maromocooo/keyrelay/hardware/case/stl/keyrelay_usba_test_touch.stl

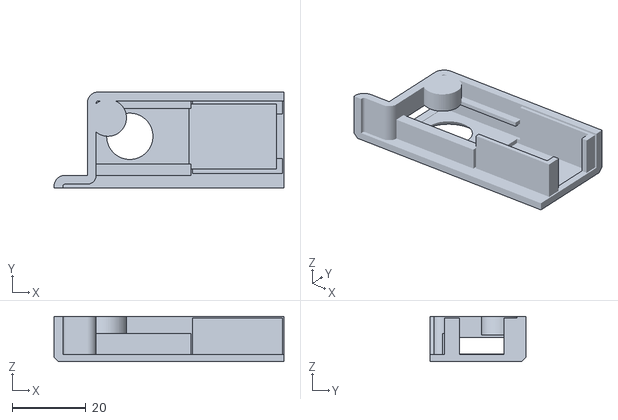
[picture p2: CAD file, 2026-10-23]
hardware/case/stl/keyrelay_usba_test_touch.stl
62.2 x 26.0 x 12.3
