maromocooo/keyrelay/hardware/case/stl/keyrelay_usba_cover.stl

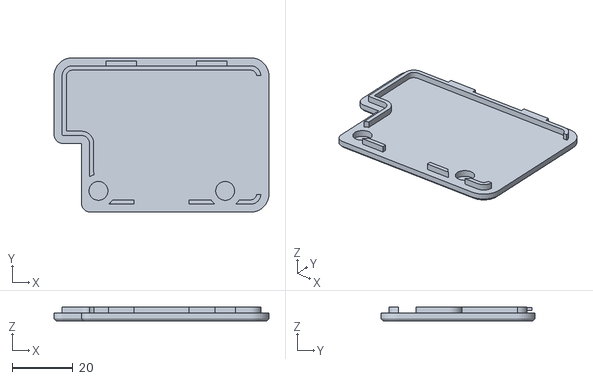
[picture p3: CAD file, 2026-10-23]
hardware/case/stl/keyrelay_usba_cover.stl
70.6 x 50.7 x 4.60
