maromocooo/keyrelay/hardware/case/stl/keyrelay_usba_test_usbc_port.stl

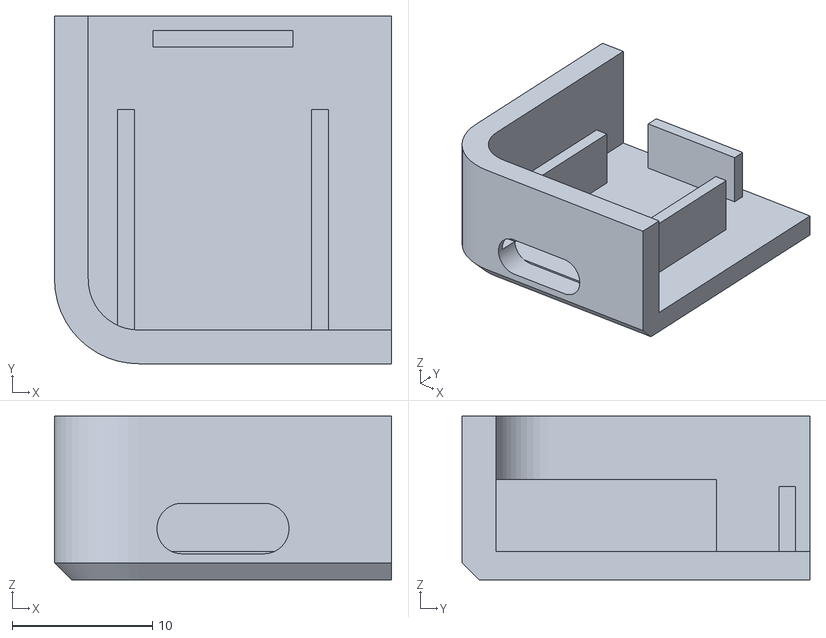
[picture p4: CAD file, 2026-10-23]
hardware/case/stl/keyrelay_usba_test_usbc_port.stl
24.0 x 24.8 x 11.6
