maromocooo/keyrelay/hardware/case/stl/keyrelay_usba_body.stl

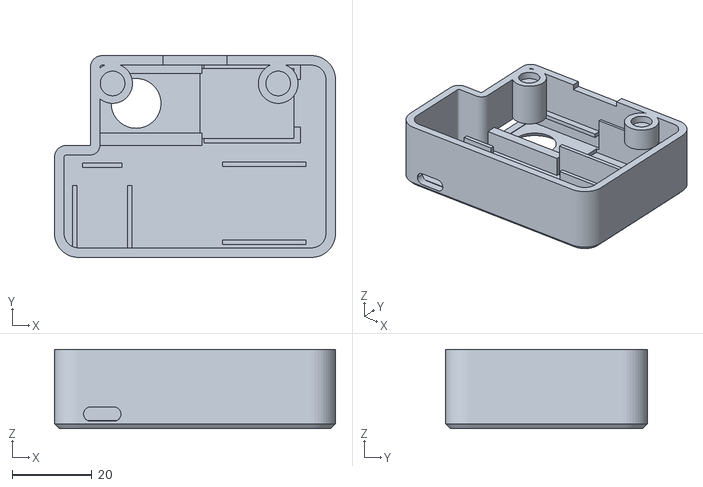
[picture p5: CAD file, 2026-10-23]
hardware/case/stl/keyrelay_usba_body.stl
70.6 x 50.7 x 19.9
