maromocooo/keyrelay/firmware/components/yd_link/yd_link_ble.c

/*
 * yd_link の BLE トランスポート（NimBLE）
 *
 *  机上ユニット = Peripheral（GATTサーバー）
 *      Service  YD_SVC
 *        ├ TO_DESK  : Write Without Response（暗号化必須）  レシーバー → 机上
 *        └ TO_RECV  : Notify                                 机上 → レシーバー
 *  レシーバー = Central（GATTクライアント）
 *      YD_SVC をアドバタイズしている机上ユニットを探して接続 → ペアリング/暗号化
 *      → サービス探索 → TO_RECV の通知を購読 → リンク確立(up)
 *
 *  1パケット = [ch(1) | payload]。BLEはリンク層で順序保証・再送されるのでCRCは不要。
 *
 *  セキュリティ:
 *   - LE Secure Connections + ボンディング（鍵はNVSに保存）
 *   - データの送受信は暗号化済みリンクのみ
 *   - 机上ユニットは「まだ誰ともペアリングしていない」か「起動後 PAIRING_WINDOW_S 秒以内」
 *     だけ新規ペアリングを受け付ける。それ以外は登録済みの相手以外を切断する
 *   - レシーバーは最初にペアリングした机上ユニットのアドレスを覚え、以後それにしか繋がない
 *   - 入出力のない機器同士なので BLE のペアリング自体は Just Works（中間者攻撃に弱い）
 *   - その上に yd_sec（事前共有鍵（鍵ファイル keyrelay-key.bin）と接続ごとの X25519 による相互認証＋
 *     AES-256-GCM）を重ねる。鍵を知らない相手とはペアリングできても1バイトもやり取りしない（yd_sec.h 参照）
 *
 *  状態: s_ready = BLE として送受信できる（暗号化＋購読済み）
 *        s_up    = yd_sec のハンドシェイク完了（ここで初めてアプリに「接続」を知らせる）
 */
#include <string.h>
#include "yd_link_priv.h"
#include "freertos/FreeRTOS.h"
#include "freertos/task.h"
#include "freertos/queue.h"
#include "freertos/semphr.h"
#include <inttypes.h>
#include "esp_log.h"
#include "esp_check.h"
#include "esp_timer.h"
#include "esp_random.h"
#include "esp_partition.h"
#include "yd_sec.h"
#include "yd_bond_policy.h"
#include "nvs_flash.h"
#include "nvs.h"
#include "nimble/nimble_port.h"
#include "nimble/nimble_port_freertos.h"
#include "host/ble_hs.h"
#include "host/util/util.h"
#include "services/gap/ble_svc_gap.h"
#include "services/gatt/ble_svc_gatt.h"
#include "yd_lang.h"

static const char *TAG = "yd_ble";

void ble_store_config_init(void);

#define PAIRING_WINDOW_S   120
#define BLE_PKT_MAX        244          /* 1(ch) + 243 */
#define TXQ_DEPTH          48
#define RXQ_DEPTH          48
#define RXQ_EV_RESERVE     4            /* 受信データで埋めず、接続・切断の通知用に空けておく枠 */

/* 128bit UUID は PSK から作る（yd_sec_gatt_uuid。3つとも別のラベルから）。固定の UUID や名前を出すと、
 * 電波を見るだけで「ここに KeyRelay がある」と分かるため。起動時の ydl_ble_init で埋める */
static ble_uuid128_t UUID_SVC     = { .u = { .type = BLE_UUID_TYPE_128 } };
static ble_uuid128_t UUID_TO_DESK = { .u = { .type = BLE_UUID_TYPE_128 } };
static ble_uuid128_t UUID_TO_RECV = { .u = { .type = BLE_UUID_TYPE_128 } };
/* 古い版（固定の UUID を出していたころ）の机上ユニットのサービス。見つけたらログで知らせるだけで、つながない */
static const ble_uuid128_t UUID_LEGACY_SVC = BLE_UUID128_INIT(0x01, 0xee, 0xff, 0xc0, 0xd0, 0x59, 0x2d, 0x9b,
                                                              0x6e, 0x4f, 0x4a, 0x5c, 0x00, 0x00, 0x1e, 0x7d);

#define HS_TIMEOUT_MS      5000          /* 暗号化・購読の後、この時間内に相互認証が終わらなければ切断 */
#define CONN_AUTH_TIMEOUT_MS 15000       /* 接続してから、この時間内に相互認証まで終わらなければ切断 */
#define KEY_PARTITION      "ydkey"       /* 鍵を書き込むパーティション（partitions.csv） */

typedef enum {
    PK_DATA = 0,        /* rx: 相手から届いたパケット / tx: アプリのデータ（暗号化して送る） */
    PK_RAW,             /* tx: ハンドシェイク（そのまま送る） */
    PK_EV_READY,        /* rx: BLE として送受信できるようになった（ハンドシェイク開始） */
    PK_EV_DOWN,         /* rx: 切れた */
} pk_kind_t;

typedef struct {
    uint8_t kind;
    uint16_t len;
    uint16_t conn;      /* tx: 送り先の接続（キューに入れた時点のもの） */
    uint32_t gen;       /* キューに入れた時点の接続の世代。違えば古い接続のものなので捨てる */
    uint8_t buf[BLE_PKT_MAX];
} pkt_t;

static yd_link_config_t s_cfg;
static bool s_is_central;
static uint8_t s_own_addr_type;
static QueueHandle_t s_txq, s_rxq;

/* いまの接続と、その接続の状態。下の5つは s_link_mutex を持って変える。
 *  - s_conn と s_gen（接続の世代）を変えるのは NimBLE のホストタスクだけ（接続・切断のとき。link_begin / link_end）。
 *    世代は接続・切断のたびに増える
 *  - 送受信キューのパケット、ハンドシェイクの状態、タイマーは、どの世代のものかを持っている。切断を決める
 *    （close_conn）・s_up を上げる（link_authed）・送る（tx_task）ときに、ロックの中でそれが今の世代かを確かめる。
 *    切断と再接続が処理の途中に起きても、古い接続の処理が新しい接続を切ったり、新しい接続に送ったり、
 *    新しい接続を認証済みにしたりしない（接続ハンドルの番号は使い回されるので、ハンドルだけでは見分けられない）
 *  - ロックを持ったまま呼ぶ NimBLE の関数（ble_gap_terminate と送信）は、ホストタスクを待たない
 *    （HCI コマンドの応答はコントローラー側の文脈で処理される）。ただし通知の送信（ble_gatts_notify_custom）は、
 *    送ったタスクの中で GAP の BLE_GAP_EVENT_NOTIFY_TX を呼ぶ。GAP のイベント処理で、そのイベントのときに
 *    s_link_mutex を取ってはいけない
 *  - s_up を変えたら notify_state() でアプリに知らせる（ロックを離してから） */
static volatile uint16_t s_conn = BLE_HS_CONN_HANDLE_NONE;
static volatile uint32_t s_gen;
static volatile bool s_up;                     /* yd_sec の相互認証まで完了（アプリにとっての「接続」） */
static volatile bool s_closing;                /* 切ると決めた。切断が終わるまでデータもハンドシェイクも進めない */
static volatile bool s_conn_authed;            /* この接続で相互認証が通った */
static volatile bool s_key_mismatch;           /* 相手の PSK が違う（AUTH が合わない）ので、こちらから切った */
static SemaphoreHandle_t s_link_mutex;
static SemaphoreHandle_t s_state_mutex;        /* state_cb を1つずつ呼ぶ */
static bool s_reported_up;                     /* state_cb で最後に知らせた値（s_state_mutex で守る） */

static volatile bool s_encrypted;
static volatile bool s_ready;        /* BLEとして送受信可（暗号化＋購読済み）。ホストタスクが変える */
static volatile bool s_subscribed;   /* peripheral: 相手が通知を購読中 */

/* peripheral */
static uint16_t s_to_desk_val, s_to_recv_val;      /* GATTサーバーのハンドル */
/* central */
static uint16_t s_svc_start, s_svc_end;
static uint16_t s_peer_to_desk, s_peer_to_recv;
static bool s_have_target;

/* いま接続している相手（暗号化できた時点で記録）。PSK の相互認証に失敗した相手と、
 * この接続で新しくペアリングしたのに認証まで進まなかった相手は、切断時に BLE のボンド情報も消す
 * （yd_bond_policy.h）。鍵を持たない偽の機器に「登録済みの相手」や新規ペアリングの枠を
 * 取られたままにしないため */
static ble_addr_t s_peer_addr;                 /* s_peer_addr_valid とともに、ホストタスクが s_link_mutex を持って変える */
static volatile bool s_peer_addr_valid;
static volatile bool s_conn_was_bonded;        /* 接続した時点で、この相手のボンドがあった（ホストタスク） */
static volatile uint32_t s_ev_drops;           /* 受信キューに状態の通知を入れられなかった回数 */
static uint32_t s_bond_delete_fail;            /* 消すべきボンドを消せなかった回数 */
static ble_addr_t s_target;

/* 受付時間中の再ペアリングで消した、古いボンドの退避（机上ユニット。yd_bond_policy.h）。ホストタスクだけが触る
 * （ydl_ble_forget_peers は active を下ろすだけ）。RAM だけに置き、再起動したら消える */
static struct {
    volatile bool active;
    uint32_t gen;                              /* 退避した接続の世代 */
    ble_addr_t addr;
    struct ble_store_value_sec our, peer;
    struct ble_store_value_cccd cccd;          /* レシーバーの通知の購読 */
    bool have_cccd;
} s_stash;

/* ======================================================================
 *  接続パラメータの省電力切り替え（Peripheral = 机上ユニットのみ）
 *
 *  通信中 : 間隔15〜30ms / レイテンシ0         → 低遅延
 *  無通信 : 間隔30ms / レイテンシ12            → 実質 (1+12)*30 = 390ms ごとにだけ起きる
 *           スーパービジョンタイムアウト 6s（≥ (1+12)*30ms*2 = 780ms かつ ≥ 4s）
 *  送受信があれば即座に「通信中」を要求し、CP_IDLE_AFTER_MS 無通信で「無通信」へ戻す。
 *  Central（レシーバー）は NimBLE 既定どおり相手の要求をそのまま受け入れる。
 * ====================================================================== */
#define CP_ACTIVE_ITVL_MIN_MS   15
#define CP_ACTIVE_ITVL_MAX_MS   30
#define CP_ACTIVE_LATENCY       0
#define CP_ACTIVE_TIMEOUT_MS    4000
#define CP_IDLE_ITVL_MS         30
#define CP_IDLE_LATENCY         12
#define CP_IDLE_TIMEOUT_MS      6000
#define CP_IDLE_AFTER_MS        3000     /* この時間無通信なら省電力パラメータへ */
#define CP_RETRY_MS             10000    /* 更新が失敗/拒否されたら次に試すまでの間隔 */
#define CP_TICK_MS              1000     /* 判定周期（tx_task のキュー待ちタイムアウト） */

static portMUX_TYPE s_cp_mux = portMUX_INITIALIZER_UNLOCKED;
static bool s_cp_enabled;                /* ble_conn_power_save && Peripheral */
static volatile bool s_cp_idle;          /* いま適用されているのが省電力パラメータか */
static volatile bool s_cp_want_idle;     /* 目標 */
static volatile bool s_cp_pending;       /* 更新手続き中 */
static int64_t s_cp_last_traffic_us;
static int64_t s_cp_retry_at_us;

static void cp_request(bool idle)
{
    struct ble_gap_upd_params p = { 0 };
    if (idle) {
        p.itvl_min = BLE_GAP_CONN_ITVL_MS(CP_IDLE_ITVL_MS);
        p.itvl_max = BLE_GAP_CONN_ITVL_MS(CP_IDLE_ITVL_MS);
        p.latency = CP_IDLE_LATENCY;
        p.supervision_timeout = BLE_GAP_SUPERVISION_TIMEOUT_MS(CP_IDLE_TIMEOUT_MS);
    } else {
        p.itvl_min = BLE_GAP_CONN_ITVL_MS(CP_ACTIVE_ITVL_MIN_MS);
        p.itvl_max = BLE_GAP_CONN_ITVL_MS(CP_ACTIVE_ITVL_MAX_MS);
        p.latency = CP_ACTIVE_LATENCY;
        p.supervision_timeout = BLE_GAP_SUPERVISION_TIMEOUT_MS(CP_ACTIVE_TIMEOUT_MS);
    }
    uint16_t conn = s_conn;
    int rc = (conn == BLE_HS_CONN_HANDLE_NONE) ? BLE_HS_ENOTCONN : ble_gap_update_params(conn, &p);
    if (rc == 0) {
        ESP_LOGI(TAG, YD_L("Requesting connection parameters: %s", "接続パラメータ変更を要求: %s"), idle ? YD_L("power save (30ms / latency 12 / 6s)", "省電力（30ms / latency 12 / 6s）") : YD_L("low latency (15-30ms / latency 0 / 4s)", "低遅延（15-30ms / latency 0 / 4s）"));
        return;
    }
    portENTER_CRITICAL(&s_cp_mux);
    s_cp_pending = false;
    /* 低遅延への切り替えはすぐ再試行、省電力側は少し待つ */
    s_cp_retry_at_us = esp_timer_get_time() + (idle ? (int64_t)CP_RETRY_MS * 1000 : 200 * 1000);
    portEXIT_CRITICAL(&s_cp_mux);
    ESP_LOGW(TAG, YD_L("Connection parameter request failed rc=%d (will retry)", "接続パラメータ変更の要求に失敗 rc=%d（後で再試行）"), rc);
}

/* 目標と現状が違えば更新を要求する（どのタスクから呼んでもよい） */
static void cp_eval(void)
{
    if (!s_cp_enabled || !s_up) {
        return;
    }
    bool req = false, want = false;
    int64_t now = esp_timer_get_time();
    portENTER_CRITICAL(&s_cp_mux);
    if (!s_cp_want_idle && (now - s_cp_last_traffic_us) >= (int64_t)CP_IDLE_AFTER_MS * 1000) {
        s_cp_want_idle = true;
    }
    want = s_cp_want_idle;
    if (want != s_cp_idle && !s_cp_pending && (!want || now >= s_cp_retry_at_us)) {
        s_cp_pending = true;
        req = true;
    }
    portEXIT_CRITICAL(&s_cp_mux);
    if (req) {
        cp_request(want);
    }
}

/* 送受信のたびに呼ぶ。省電力側なら低遅延側へ戻す */
static void cp_on_traffic(void)
{
    if (!s_cp_enabled) {
        return;
    }
    portENTER_CRITICAL(&s_cp_mux);
    s_cp_last_traffic_us = esp_timer_get_time();
    s_cp_want_idle = false;
    bool need = s_cp_idle && !s_cp_pending;
    portEXIT_CRITICAL(&s_cp_mux);
    if (need) {
        cp_eval();
    }
}

static void cp_reset(bool idle_now)
{
    portENTER_CRITICAL(&s_cp_mux);
    s_cp_idle = idle_now;
    s_cp_want_idle = false;
    s_cp_pending = false;
    s_cp_last_traffic_us = esp_timer_get_time();
    s_cp_retry_at_us = 0;
    portEXIT_CRITICAL(&s_cp_mux);
}

static void log_conn_params(const char *label, uint16_t conn)
{
    struct ble_gap_conn_desc d;
    if (ble_gap_conn_find(conn, &d) != 0) {
        return;
    }
    unsigned itvl_x100 = (unsigned)d.conn_itvl * 125;   /* 1.25ms単位 → 0.01ms単位 */
    ESP_LOGI(TAG, YD_L("%s interval=%u.%02ums latency=%u timeout=%ums (effective wake-up interval ~%ums)", "%s interval=%u.%02ums latency=%u timeout=%ums（実質の起床間隔 約%ums）"),
             label, itvl_x100 / 100, itvl_x100 % 100, d.conn_latency, (unsigned)d.supervision_timeout * 10,
             (unsigned)(itvl_x100 * (1u + d.conn_latency)) / 100);
}

void ydl_ble_get_conn_info(yd_link_conn_info_t *out)
{
    struct ble_gap_conn_desc d;
    uint16_t conn = s_conn;
    out->connected = s_up;
    out->power_save = s_cp_idle;
    out->update_pending = s_cp_pending;
    if (conn != BLE_HS_CONN_HANDLE_NONE && ble_gap_conn_find(conn, &d) == 0) {
        out->itvl = d.conn_itvl;
        out->latency = d.conn_latency;
        out->timeout = d.supervision_timeout;
    }
}

/* s_up が変わっていたらアプリに知らせる。s_up を変えたタスクが、s_link_mutex を離してから呼ぶ
 * （state_cb の中から送信できるように）。複数のタスクが続けて変えても、最後に知らせる値は今の s_up になる
 * （途中の変化は飛ばすことがある） */
static void notify_state(void)
{
    xSemaphoreTake(s_state_mutex, portMAX_DELAY);
    bool up = s_up;
    if (up != s_reported_up) {
        s_reported_up = up;
        ESP_LOGI(TAG, "%s", up ? YD_L("▶ BLE link up (encrypted, mutually authenticated with the key)", "▶ BLEリンク確立（暗号化＋鍵による相互認証済み）") : YD_L("■ BLE link down", "■ BLEリンク切断"));
        if (up && s_cp_enabled) {
            /* 確立直後はレシーバーが指定した低遅延パラメータ。CP_IDLE_AFTER_MS 後に省電力へ */
            struct ble_gap_conn_desc d;
            uint16_t c = s_conn;
            cp_reset(c != BLE_HS_CONN_HANDLE_NONE && ble_gap_conn_find(c, &d) == 0 && d.conn_latency > 0);
        }
        if (s_cfg.state_cb) {
            s_cfg.state_cb(up, s_cfg.state_cb_arg);
        }
    }
    xSemaphoreGive(s_state_mutex);
}

static void print_addr(const char *label, const ble_addr_t *a)
{
    const uint8_t *v = a->val;
    ESP_LOGI(TAG, "%s %02x:%02x:%02x:%02x:%02x:%02x", label, v[5], v[4], v[3], v[2], v[1], v[0]);
}

static int bond_count(void)
{
    int n = 0;
    ble_store_util_count(BLE_STORE_OBJ_TYPE_OUR_SEC, &n);
    return n;
}

static bool peer_is_bonded(const ble_addr_t *addr)
{
    struct ble_store_key_sec key = { .peer_addr = *addr };
    struct ble_store_value_sec val;
    return ble_store_read_peer_sec(&key, &val) == 0;
}

static bool pairing_window_open(void)
{
    return bond_count() == 0 || esp_timer_get_time() < (int64_t)PAIRING_WINDOW_S * 1000000;
}

/* ---- NVS: レシーバーが覚える相手アドレス ---- */
static void target_load(void)
{
    nvs_handle_t h;
    if (nvs_open("yd_link", NVS_READONLY, &h) != ESP_OK) {
        return;
    }
    size_t sz = sizeof(s_target);
    s_have_target = (nvs_get_blob(h, "target", &s_target, &sz) == ESP_OK && sz == sizeof(s_target));
    nvs_close(h);
}

/* 登録済みの机上ユニットか（レシーバー） */
static bool is_target(const ble_addr_t *a)
{
    return s_have_target && ble_addr_cmp(a, &s_target) == 0;
}

static void target_save(const ble_addr_t *a)
{
    nvs_handle_t h;
    if (nvs_open("yd_link", NVS_READWRITE, &h) != ESP_OK) {
        return;
    }
    nvs_set_blob(h, "target", a, sizeof(*a));
    nvs_commit(h);
    nvs_close(h);
    s_target = *a;
    s_have_target = true;
}

/* ======================================================================
 *  受信・送信タスク（NimBLEホストタスクを塞がないため）
 * ====================================================================== */
/* ======================================================================
 *  yd_sec: 事前共有鍵による相互認証と暗号化（ハンドシェイクは rx_task だけが触る）
 * ====================================================================== */
static uint8_t s_psk[YD_SEC_KEY_LEN];
static bool s_have_psk;
static SemaphoreHandle_t s_sec_mutex;      /* tx_task（暗号化）と rx_task（鍵の更新）の排他 */
static yd_sec_keys_t s_keys;
static uint8_t s_my_nonce[YD_SEC_NONCE_LEN], s_peer_nonce[YD_SEC_NONCE_LEN];
static uint8_t s_my_esk[YD_SEC_EPK_LEN];                      /* この接続だけの X25519 秘密鍵（RAM のみ） */
static uint8_t s_my_epk[YD_SEC_EPK_LEN], s_peer_epk[YD_SEC_EPK_LEN];
static int64_t s_x25519_us;                                    /* X25519 の計算にかかった時間（ログ用） */
static uint8_t s_peer_mac[YD_SEC_MAC_LEN];
static bool s_hs_hello_sent, s_hs_peer_hello, s_hs_keys, s_hs_auth_sent, s_hs_peer_auth;
static bool s_keys_valid;              /* s_keys がこの接続の鍵（s_sec_mutex で守る） */
static uint32_t s_tx_ctr, s_rx_ctr;
static uint32_t s_rx_overflows_seen;   /* 鍵を作ったときの g_ydl_stats.rx_overflows（抜けの原因の見分け用） */
static esp_timer_handle_t s_hs_timer;
static esp_timer_handle_t s_conn_timer;
/* タイマーをどの世代の接続のために、いつまでの期限で動かしたか（s_link_mutex で守る）。止めたはずの前の分が
 * 遅れて呼ばれても、期限前なら何もしない */
static uint32_t s_hs_timer_gen, s_conn_timer_gen;
static int64_t s_hs_timer_due_us, s_conn_timer_due_us;
static uint32_t s_hs_gen;                    /* ハンドシェイクの状態（上の s_hs_* と鍵）がどの世代のものか（rx_task だけが触る） */
static uint16_t s_hs_conn;                   /* その接続のハンドル */
static TaskHandle_t s_rx_task;
static uint32_t s_sec_fail;

/* 接続した（ホストタスク）。新しい世代を始め、接続ごとの状態を初期値に戻す */
static void link_begin(uint16_t conn)
{
    xSemaphoreTake(s_link_mutex, portMAX_DELAY);
    s_conn = conn;
    s_gen++;
    s_up = false;
    s_closing = false;
    s_conn_authed = false;
    s_key_mismatch = false;
    s_peer_addr_valid = false;
    xSemaphoreGive(s_link_mutex);
    notify_state();
}

/* 暗号化できた相手のアドレスを覚える（ホストタスク） */
static void link_set_peer(const ble_addr_t *a)
{
    xSemaphoreTake(s_link_mutex, portMAX_DELAY);
    s_peer_addr = *a;
    s_peer_addr_valid = true;
    xSemaphoreGive(s_link_mutex);
}

/* 切れた（ホストタスク）。切れた接続が認証済みだったか・相手の PSK が違うので切ったかと、その接続の世代を返す。
 * 世代が変わるので、これより後に古い接続の処理が切断を決めても、もう何も変わらない */
static uint32_t link_end(bool *authed, bool *key_mismatch)
{
    xSemaphoreTake(s_link_mutex, portMAX_DELAY);
    uint32_t gen = s_gen;
    *authed = s_conn_authed;
    *key_mismatch = s_key_mismatch;
    s_conn = BLE_HS_CONN_HANDLE_NONE;
    s_gen++;
    s_up = false;
    s_closing = false;
    s_conn_authed = false;
    s_key_mismatch = false;
    xSemaphoreGive(s_link_mutex);
    notify_state();
    return gen;
}

/* いまの接続と世代を、組み合わせが崩れないように読む。その時点で相互認証が済んでいれば（s_up）true */
static bool link_snapshot(uint16_t *conn, uint32_t *gen)
{
    xSemaphoreTake(s_link_mutex, portMAX_DELAY);
    *conn = s_conn;
    *gen = s_gen;
    bool up = s_up;
    xSemaphoreGive(s_link_mutex);
    return up;
}

/* BLE として送受信できなくなった（ホストタスク。購読の解除など、接続は残ることがある） */
static void link_clear_up(void)
{
    xSemaphoreTake(s_link_mutex, portMAX_DELAY);
    s_up = false;
    xSemaphoreGive(s_link_mutex);
    notify_state();
}

/* 相互認証が通った（rx_task）。gen がまだ今の接続で、切ると決めていなければ s_up を上げて true。
 * 相互認証までの時間切れタイマーもここで止める（ロックの中なので、次の接続のタイマーは止めない）。
 * *peer_valid と *peer に、その接続の相手のアドレス（暗号化できていれば）を返す */
static bool link_authed(uint32_t gen, ble_addr_t *peer, bool *peer_valid)
{
    bool ok = false;
    xSemaphoreTake(s_link_mutex, portMAX_DELAY);
    if (gen == s_gen && s_conn != BLE_HS_CONN_HANDLE_NONE && s_ready && !s_closing) {
        s_conn_authed = true;
        s_up = true;
        esp_timer_stop(s_hs_timer);
        esp_timer_stop(s_conn_timer);
        ok = true;
    }
    *peer_valid = ok && s_peer_addr_valid;
    *peer = s_peer_addr;
    xSemaphoreGive(s_link_mutex);
    return ok;
}

/* 鍵を消した（rx_task。EV_DOWN）。同じ接続のまま購読をやり直したとき、その間に終わったハンドシェイクで
 * 上げた s_up を残さない。残ると、鍵のないまま「接続中」のままになり、次のハンドシェイクも始まらない */
static void link_keys_gone(uint32_t gen)
{
    bool changed = false;
    xSemaphoreTake(s_link_mutex, portMAX_DELAY);
    if (gen == s_gen && s_up) {
        s_up = false;
        changed = true;
    }
    xSemaphoreGive(s_link_mutex);
    if (changed) {
        notify_state();
    }
}

#define CLOSE_HS_FAIL        0x01   /* 鍵の相互認証の前の失敗として切る（ログをエラーにする） */
#define CLOSE_UNLESS_UP      0x02   /* いま相互認証が済んでいれば（s_up）切らない */
#define CLOSE_UNLESS_AUTHED  0x04   /* この接続で一度でも相互認証が通っていれば切らない */
#define CLOSE_KEY_MISMATCH   0x08   /* 相手の PSK が違う。前からのボンドも消す（yd_bond_policy.h） */

/* gen の接続を切ると決めて、切断を要求する。切ったら true。gen がもう今の接続でない（切れた後の、古い接続の
 * 処理から呼ばれた）とき、すでに切ると決めているとき、flags の条件に当たるときは何もしない。
 * why を渡せば、切ったときにログに出す */
static bool close_conn(uint32_t gen, unsigned flags, const char *why)
{
    bool closed = false;
    xSemaphoreTake(s_link_mutex, portMAX_DELAY);
    if (gen == s_gen && s_conn != BLE_HS_CONN_HANDLE_NONE && !s_closing &&
        !((flags & CLOSE_UNLESS_UP) && s_up) && !((flags & CLOSE_UNLESS_AUTHED) && s_conn_authed)) {
        if ((flags & CLOSE_KEY_MISMATCH) && !s_up) {
            /* 相手の PSK が違う。前からのボンドでも消す。それ以外の認証前の失敗（時間切れ・形のおかしい HELLO/AUTH
             * など）では、この接続で作ったボンドだけを消す（conn_end）。前からのボンドを使って暗号化できた相手は
             * 本物の相手で、こちらだけが忘れると、相手は暗号化に失敗し続けてつながらなくなるため */
            s_key_mismatch = true;
        }
        s_closing = true;
        s_up = false;      /* 切断が終わるのを待たずに送受信を止める（後続の通し番号を相手に送らない） */
        ble_gap_terminate(s_conn, (flags & CLOSE_HS_FAIL) ? BLE_ERR_AUTH_FAIL : BLE_ERR_REM_USER_CONN_TERM);
        closed = true;
    }
    xSemaphoreGive(s_link_mutex);
    if (closed) {
        if (why && (flags & CLOSE_HS_FAIL)) {
            ESP_LOGE(TAG, YD_L("%s → disconnecting", "%s → 切断します"), why);
        } else if (why) {
            ESP_LOGW(TAG, YD_L("%s → disconnecting", "%s → 切断します"), why);
        }
        notify_state();
    }
    return closed;
}

/* 接続・切断の通知。受信データと同じキューに入れて順番を保つ（切断より前のデータは、
 * 切断の処理より先に読まれる）。push_rx は最後の RXQ_EV_RESERVE 枠を使わないので、相手が
 * データを送りつけてキューを埋めても、通知は入る。どちらも NimBLE のホストタスクからしか
 * 呼ばれないので、空きの確認と投入の間に割り込まれることはない */
static void post_event(pk_kind_t kind)
{
    pkt_t p = { .kind = kind, .len = 0, .conn = s_conn, .gen = s_gen };   /* ホストタスク（書き手）から呼ばれる */
    if (xQueueSend(s_rxq, &p, pdMS_TO_TICKS(100)) != pdTRUE) {
        s_ev_drops++;
        ESP_LOGE(TAG, YD_L("Could not queue a link state event (#%", "接続状態の通知をキューに入れられませんでした（%") PRIu32 YD_L(") → disconnecting", "回目）→ 切断します"), s_ev_drops);
        uint16_t c = s_conn;
        if (c != BLE_HS_CONN_HANDLE_NONE) {
            ble_gap_terminate(c, BLE_ERR_REM_USER_CONN_TERM);
        }
    }
}

/* BLE層の「送受信できる / できない」。アプリへの通知はハンドシェイク完了後 */
static void transport_ready(bool ready)
{
    if (ready && s_ready) {
        return;
    }
    /* 切断は毎回通知する（準備完了前に届いたHELLOなどの状態も確実に消すため） */
    s_ready = ready;
    if (!ready) {
        link_clear_up();            /* 先に送信を止める */
        if (s_hs_timer) {
            esp_timer_stop(s_hs_timer);
        }
    }
    post_event(ready ? PK_EV_READY : PK_EV_DOWN);
}

/* rx_task の中から、いま処理しているハンドシェイクの接続を切る（古い接続の処理なら何もしない）。
 * hs_fail: 失敗として切る（この接続で作ったボンドは消え、前からのボンドは残る）
 * hs_mismatch: 相手の PSK が違うとして切る（前からのボンドも消す）
 * hs_drop: 失敗の印を付けずに切る（版の違い・取りこぼしなど） */
static void hs_fail(const char *why)
{
    close_conn(s_hs_gen, CLOSE_HS_FAIL, why);
}

static void hs_mismatch(const char *why)
{
    close_conn(s_hs_gen, CLOSE_HS_FAIL | CLOSE_KEY_MISMATCH, why);
}

static void hs_drop(const char *why)
{
    close_conn(s_hs_gen, 0, why);
}

static int esp_rng(void *ctx, unsigned char *buf, size_t len)
{
    (void)ctx;
    esp_fill_random(buf, len);
    return 0;
}

/* タイマーを動かす。gen の接続のため、timeout_ms 後まで */
static void timer_arm(esp_timer_handle_t t, uint32_t *gen_slot, int64_t *due_slot, uint32_t gen, uint32_t timeout_ms)
{
    esp_timer_stop(t);
    xSemaphoreTake(s_link_mutex, portMAX_DELAY);
    *gen_slot = gen;
    *due_slot = esp_timer_get_time() + (int64_t)timeout_ms * 1000;
    xSemaphoreGive(s_link_mutex);
    esp_timer_start_once(t, (uint64_t)timeout_ms * 1000);
}

/* タイマーの呼び出しが、いま動かしている分の期限によるものなら true と、その世代 */
static bool timer_due(const uint32_t *gen_slot, const int64_t *due_slot, uint32_t *gen)
{
    xSemaphoreTake(s_link_mutex, portMAX_DELAY);
    *gen = *gen_slot;
    bool due = esp_timer_get_time() >= *due_slot - 2000;    /* 2ms の余裕（前に動かした分は何秒も前の期限） */
    xSemaphoreGive(s_link_mutex);
    return due;
}

static void hs_timeout_cb(void *arg)
{
    uint32_t gen;
    if (timer_due(&s_hs_timer_gen, &s_hs_timer_due_us, &gen) && s_ready) {
        close_conn(gen, CLOSE_HS_FAIL | CLOSE_UNLESS_UP,
                   YD_L("Key-based mutual authentication timed out (peer firmware may be old, or it has no key)", "鍵による相互認証が時間内に終わりませんでした（相手のファームが古いか、鍵がない可能性）"));
    }
}

/* 接続してから相互認証が終わるまでの上限。s_hs_timer は暗号化と購読が済んでから動くので、
 * 暗号化や購読をしないまま接続だけを続ける相手（1つしかない接続枠の占有）はこちらで切る。
 * 失敗の印は付けない（前からのボンドは残し、この接続で作られたボンドは yd_bond_policy で消える） */
static void conn_timeout_cb(void *arg)
{
    uint32_t gen;
    if (timer_due(&s_conn_timer_gen, &s_conn_timer_due_us, &gen) && close_conn(gen, CLOSE_UNLESS_AUTHED, NULL)) {
        ESP_LOGW(TAG, YD_L("Not authenticated within %d s of connecting → disconnecting",
                           "接続から %d 秒以内に相互認証が終わりませんでした → 切断します"), CONN_AUTH_TIMEOUT_MS / 1000);
    }
}

static void hs_reset(void)
{
    xSemaphoreTake(s_sec_mutex, portMAX_DELAY);
    yd_sec_wipe(&s_keys, sizeof(s_keys));
    s_keys_valid = false;
    s_tx_ctr = s_rx_ctr = 0;
    xSemaphoreGive(s_sec_mutex);
    yd_sec_wipe(s_my_nonce, sizeof(s_my_nonce));
    yd_sec_wipe(s_peer_nonce, sizeof(s_peer_nonce));
    yd_sec_wipe(s_my_esk, sizeof(s_my_esk));
    yd_sec_wipe(s_my_epk, sizeof(s_my_epk));
    yd_sec_wipe(s_peer_epk, sizeof(s_peer_epk));
    s_hs_hello_sent = s_hs_peer_hello = s_hs_keys = s_hs_auth_sent = s_hs_peer_auth = false;
}

/* ハンドシェイクのパケットを、いま処理しているハンドシェイクの接続に送る（rx_task だけが呼ぶ）。
 * その接続がもう切れていれば tx_task が捨てる */
static void send_raw(const uint8_t *buf, uint16_t len)
{
    pkt_t p = { .kind = PK_RAW, .len = len, .conn = s_hs_conn, .gen = s_hs_gen };
    memcpy(p.buf, buf, len);
    if (xQueueSend(s_txq, &p, pdMS_TO_TICKS(100)) != pdTRUE) {
        hs_drop(YD_L("Could not queue a handshake packet", "ハンドシェイクのパケットを送信キューに入れられませんでした"));
    }
}

static uint8_t my_role(void) { return s_is_central ? YD_SEC_ROLE_CENTRAL : YD_SEC_ROLE_PERIPHERAL; }
static uint8_t peer_role(void) { return s_is_central ? YD_SEC_ROLE_PERIPHERAL : YD_SEC_ROLE_CENTRAL; }
static const uint8_t *nonce_c(void) { return s_is_central ? s_my_nonce : s_peer_nonce; }
static const uint8_t *nonce_p(void) { return s_is_central ? s_peer_nonce : s_my_nonce; }

/* 揃った材料に応じて先へ進める */
static void hs_progress(void)
{
    if (s_hs_gen != s_gen || s_up || !s_ready || s_closing) {
        return;     /* 古い接続の分、すでに認証済み、送受信の準備前、切ると決めた */
    }
    if (s_hs_hello_sent && s_hs_peer_hello && !s_hs_keys) {
        uint8_t dh[YD_SEC_EPK_LEN];
        int64_t t0 = esp_timer_get_time();
        int xrc = yd_sec_x25519_shared(s_my_esk, s_peer_epk, dh, esp_rng, NULL);
        s_x25519_us += esp_timer_get_time() - t0;
        ESP_LOGI(TAG, YD_L("X25519 key exchange: %lld ms", "X25519 の鍵交換: %lld ms"), s_x25519_us / 1000);
        if (xrc != 0) {
            yd_sec_wipe(s_my_esk, sizeof(s_my_esk));
            hs_fail(YD_L("Key exchange failed (invalid public key from the peer)", "鍵交換に失敗（相手の公開鍵が不正）"));
            return;
        }
        yd_sec_wipe(s_my_esk, sizeof(s_my_esk));   /* 秘密鍵はもう要らない。残さないことで前方秘匿性になる */
        const uint8_t *epk_c = s_is_central ? s_my_epk : s_peer_epk;
        const uint8_t *epk_p = s_is_central ? s_peer_epk : s_my_epk;
        xSemaphoreTake(s_sec_mutex, portMAX_DELAY);
        int rc = yd_sec_derive(s_psk, nonce_c(), nonce_p(), epk_c, epk_p, dh, &s_keys);
        s_keys_valid = (rc == 0);
        s_tx_ctr = s_rx_ctr = 0;
        s_rx_overflows_seen = g_ydl_stats.rx_overflows;
        xSemaphoreGive(s_sec_mutex);
        yd_sec_wipe(dh, sizeof(dh));
        if (rc != 0) {
            hs_fail(YD_L("Key derivation failed", "鍵の導出に失敗"));
            return;
        }
        s_hs_keys = true;
    }
    if (s_hs_keys && !s_hs_auth_sent) {
        uint8_t m[1 + YD_SEC_MAC_LEN] = { YD_SEC_T_AUTH };
        if (yd_sec_auth_mac(&s_keys, my_role(), nonce_c(), nonce_p(), &m[1]) != 0) {
            hs_fail(YD_L("Computing the AUTH MAC failed", "AUTH の MAC の計算に失敗"));
            return;
        }
        send_raw(m, sizeof(m));
        s_hs_auth_sent = true;
    }
    if (s_hs_keys && s_hs_auth_sent && s_hs_peer_auth) {
        uint8_t expect[YD_SEC_MAC_LEN];
        int rc = yd_sec_auth_mac(&s_keys, peer_role(), nonce_c(), nonce_p(), expect);
        bool ok = rc == 0 && yd_sec_equal(expect, s_peer_mac, YD_SEC_MAC_LEN);
        yd_sec_wipe(expect, sizeof(expect));
        if (rc != 0) {
            hs_fail(YD_L("Computing the AUTH MAC failed", "AUTH の MAC の計算に失敗"));
            return;
        }
        if (!ok) {
            s_sec_fail++;
            hs_mismatch(YD_L("Peer key does not match. Flash the same key file to both units", "相手の鍵が一致しません。2台に同じ鍵ファイルを書き込んでください"));
            return;
        }
        ble_addr_t peer;
        bool peer_valid;
        if (!link_authed(s_hs_gen, &peer, &peer_valid)) {
            return;     /* 計算している間に切れた（または切ると決めた）。この接続はもう使わない */
        }
        if (s_is_central && !s_have_target && peer_valid) {
            target_save(&peer);          /* 鍵の相互認証が通った相手だけを登録する */
            print_addr(YD_L("Registered this desk unit:", "この机上ユニットを登録しました:"), &peer);
        }
        notify_state();
    }
}

static void send_hello(void)
{
    esp_fill_random(s_my_nonce, sizeof(s_my_nonce));
    esp_fill_random(s_my_esk, sizeof(s_my_esk));
    int64_t t0 = esp_timer_get_time();
    int rc = yd_sec_x25519_public(s_my_esk, s_my_epk, esp_rng, NULL);
    s_x25519_us = esp_timer_get_time() - t0;
    if (rc != 0) {
        yd_sec_wipe(s_my_esk, sizeof(s_my_esk));
        hs_fail(YD_L("Could not create the X25519 key", "X25519 の鍵を作れませんでした"));
        return;
    }
    uint8_t m[YD_SEC_HELLO_LEN];
    yd_sec_hello_build(m, my_role(), s_my_nonce, s_my_epk);
    send_raw(m, sizeof(m));
    s_hs_hello_sent = true;
}

/* 状態は EV_DOWN（切断）でだけ消す。相手のHELLOが先に届いていることがあるため。
 * HELLO はレシーバー（Central）から始める。Central はサービス探索と購読を終えてから送るので、
 * 机上ユニットの返事を取りこぼさない。机上ユニットは HELLO を受け取ってから返す（on_packet） */
static void hs_begin(void)
{
    if (!s_have_psk) {
        hs_fail(YD_L("No key (keyrelay-key.bin) has been flashed", "鍵（keyrelay-key.bin）が書き込まれていません"));
        return;
    }
    if (!s_hs_hello_sent && (s_is_central || s_hs_peer_hello)) {
        send_hello();   /* 机上ユニット: 準備が整う前にレシーバーの HELLO が届いていたら、ここで返す */
    }
    timer_arm(s_hs_timer, &s_hs_timer_gen, &s_hs_timer_due_us, s_hs_gen, HS_TIMEOUT_MS);
    hs_progress();
}

/* 相手から届いた1パケット */
static void on_packet(const pkt_t *p)
{
    static uint8_t pt[BLE_PKT_MAX];
    if (s_conn == BLE_HS_CONN_HANDLE_NONE || p->len < 1) {
        return;
    }
    switch (p->buf[0]) {
    case YD_SEC_T_HELLO: {
        uint8_t ver = 0;
        int hr = s_hs_peer_hello ? YD_SEC_HELLO_MALFORMED
                                 : yd_sec_hello_parse(p->buf, p->len, peer_role(), s_peer_nonce, s_peer_epk, &ver);
        if (hr == YD_SEC_HELLO_VERSION) {
            ESP_LOGE(TAG, YD_L("The peer speaks KeyRelay link protocol v%u, this firmware v%u. Flash the same KeyRelay version to both units",
                               "相手は KeyRelay のリンクの版 v%u、このファームは v%u です。2台に同じ版の KeyRelay を書き込んでください"),
                     ver, YD_SEC_VERSION);
            hs_drop(YD_L("Protocol version mismatch", "版の違い"));
            return;
        }
        if (hr != YD_SEC_HELLO_OK) {
            hs_fail(YD_L("Malformed HELLO", "不正なHELLO"));
            return;
        }
        s_hs_peer_hello = true;
        if (!s_hs_hello_sent && s_ready && s_have_psk) {
            send_hello();       /* 机上ユニット: 受け取ってから返す */
        }
        hs_progress();
        return;
    }
    case YD_SEC_T_AUTH:
        if (p->len != 1 + YD_SEC_MAC_LEN || s_hs_peer_auth) {
            hs_fail(YD_L("Malformed AUTH", "不正なAUTH"));
            return;
        }
        memcpy(s_peer_mac, &p->buf[1], YD_SEC_MAC_LEN);
        s_hs_peer_auth = true;
        hs_progress();
        return;
    case YD_SEC_T_DATA: {
        if (!s_up) {
            return;
        }
        uint32_t ctr = 0;
        xSemaphoreTake(s_sec_mutex, portMAX_DELAY);
        if (!s_keys_valid) {
            xSemaphoreGive(s_sec_mutex);
            return;     /* この接続の鍵がない（消した直後など）。消した鍵（0）で読まない */
        }
        int n = yd_sec_open(s_is_central ? s_keys.k_p2c : s_keys.k_c2p, p->buf, p->len, &ctr, pt, sizeof(pt));
        uint32_t expect = s_rx_ctr + 1;
        bool next = (n >= 1) && ctr == expect;     /* 1 ずつ増えるものだけ（抜き取り・並べ替えも検出） */
        if (next) {
            s_rx_ctr = ctr;
        }
        xSemaphoreGive(s_sec_mutex);
        if (n < 1) {
            s_sec_fail++;
            hs_fail(YD_L("Received tampered or corrupted data", "改ざんされたか壊れたデータを受信"));
            return;
        }
        if (!next) {
            yd_sec_wipe(pt, sizeof(pt));
            if (ctr > expect && g_ydl_stats.rx_overflows != s_rx_overflows_seen) {
                /* 自分の受信キューが一杯で捨てた分。データが欠けたので、つなぎ直して揃える */
                hs_drop(YD_L("A packet was lost (receive queue full)", "パケットを取りこぼしました（受信キューが一杯）"));
            } else {
                s_sec_fail++;
                hs_fail(ctr < expect ? YD_L("Received data with an old sequence number (possible replay)", "古い通し番号のデータを受信（リプレイの疑い）")
                                           : YD_L("A packet is missing (lost on the way, or removed by an attacker)", "パケットが抜けています（途中で失われたか、攻撃で抜き取られた）"));
            }
            return;
        }
        g_ydl_stats.rx_frames++;
        if (s_cfg.rx_cb) {
            /* rx_cb は同期で、必要なら中身を自分のキューにコピーしてから戻る */
            s_cfg.rx_cb(pt[0], &pt[1], (uint16_t)(n - 1), s_cfg.rx_cb_arg);
        }
        yd_sec_wipe(pt, sizeof(pt));   /* 復号した平文を残さない */
        return;
    }
    default:
        hs_fail(YD_L("Received unencrypted data (peer firmware may be old)", "暗号化されていないデータを受信（相手のファームが古い可能性）"));
        return;
    }
}

static bool load_psk(void)
{
    const esp_partition_t *part = esp_partition_find_first(ESP_PARTITION_TYPE_DATA, ESP_PARTITION_SUBTYPE_ANY, KEY_PARTITION);
    if (!part) {
        ESP_LOGE(TAG, YD_L("Partition \"%s\" not found (outdated partition table)", "パーティション \"%s\" がありません（パーティションテーブルが古い）"), KEY_PARTITION);
        return false;
    }
    uint8_t buf[YD_SEC_KEYFILE_LEN];
    if (esp_partition_read(part, 0, buf, sizeof(buf)) != ESP_OK) {
        return false;
    }
    bool ok = yd_sec_parse_keyfile(buf, sizeof(buf), s_psk);
    yd_sec_wipe(buf, sizeof(buf));
    if (ok) {
        ESP_LOGI(TAG, YD_L("Key loaded (0x%06", "鍵を読み込みました（0x%06") PRIx32 YD_L(")", "）"), part->address);
    } else {
        ESP_LOGE(TAG, YD_L("No key. Flash the key file (keyrelay-key.bin) at 0x%06", "鍵がありません。鍵ファイル（keyrelay-key.bin）を 0x%06") PRIx32 YD_L(" (see docs/BUILD.md)", " に書き込んでください（docs/BUILD.md 参照）"), part->address);
    }
    return ok;
}

/* ======================================================================
 *  受信・送信タスク（NimBLEホストタスクを塞がないため）
 * ====================================================================== */
static void push_rx(struct os_mbuf *om)
{
    pkt_t p = { .kind = PK_DATA, .conn = s_conn, .gen = s_gen };   /* ホストタスク（書き手）から呼ばれる */
    uint16_t n = 0;
    if (ble_hs_mbuf_to_flat(om, p.buf, sizeof(p.buf), &n) != 0 || n < 1) {
        g_ydl_stats.rx_overflows++;
        return;
    }
    p.len = n;
    if (uxQueueSpacesAvailable(s_rxq) <= RXQ_EV_RESERVE || xQueueSend(s_rxq, &p, 0) != pdTRUE) {
        g_ydl_stats.rx_overflows++;
    }
}

static void rx_task(void *arg)
{
    static pkt_t p;
    for (;;) {
        xQueueReceive(s_rxq, &p, portMAX_DELAY);
        if (p.kind == PK_EV_DOWN) {
            hs_reset();
            link_keys_gone(p.gen);
            continue;
        }
        if (p.gen != s_gen) {
            continue;   /* 切断より前に届いた古い接続の分は、新しい接続として扱わない */
        }
        if (p.gen != s_hs_gen) {
            /* 新しい接続の最初の通知かパケット。前の接続の状態は持ち越さない（EV_DOWN を取りこぼしていても） */
            hs_reset();
            s_hs_gen = p.gen;
            s_hs_conn = p.conn;
        }
        if (p.kind == PK_EV_READY) {
            hs_begin();
        } else {
            on_packet(&p);
        }
    }
}

/* tx_task が s_link_mutex を持ったまま呼ぶ。通知の送信は、このタスクの中で GAP の NOTIFY_TX を呼ぶ
 * （gap_event_periph はそのイベントで何もしない） */
static int send_one(uint16_t conn, const uint8_t *buf, uint16_t len)
{
    if (s_is_central) {
        return ble_gattc_write_no_rsp_flat(conn, s_peer_to_desk, buf, len);
    }
    struct os_mbuf *om = ble_hs_mbuf_from_flat(buf, len);
    if (!om) {
        return BLE_HS_ENOMEM;
    }
    return ble_gatts_notify_custom(conn, s_to_recv_val, om);   /* omは成否に関わらず消費される */
}

/* 1パケットに使える長さ（ATT の MTU と BLE_PKT_MAX の小さいほう） */
static size_t wire_cap(uint16_t conn)
{
    uint16_t mtu = ble_att_mtu(conn);
    size_t wire = BLE_PKT_MAX;
    if (mtu > 3 && (size_t)mtu - 3 < wire) {
        wire = (size_t)mtu - 3;
    }
    return wire;
}

static void tx_task(void *arg)
{
    static pkt_t p;
    static uint8_t out[BLE_PKT_MAX];
    for (;;) {
        if (xQueueReceive(s_txq, &p, s_cp_enabled ? pdMS_TO_TICKS(CP_TICK_MS) : portMAX_DELAY) != pdTRUE) {
            cp_eval();   /* 無通信が続いていれば省電力パラメータへ */
            continue;
        }
        const uint8_t *buf = p.buf;
        uint16_t len = p.len;
        if (p.gen != s_gen) {
            /* 切断までに送れなかった古い接続の分。新しい接続には送らない */
            if (p.kind != PK_RAW) {
                g_ydl_stats.tx_dropped++;
            }
            yd_sec_wipe(p.buf, p.len);
            continue;
        }
        if (p.kind == PK_RAW) {
            if (!s_ready) {
                continue;
            }
        } else {
            size_t cap = wire_cap(p.conn);
            xSemaphoreTake(s_sec_mutex, portMAX_DELAY);
            int n = -1;
            /* 鍵が有効か・接続が同じかは、鍵を消す hs_reset と同じロックの中で確かめる */
            bool live = s_up && s_keys_valid && p.gen == s_gen;
            if (live && s_tx_ctr < UINT32_MAX) {
                n = yd_sec_seal(s_is_central ? s_keys.k_c2p : s_keys.k_p2c, ++s_tx_ctr, p.buf, p.len, out, cap);
            }
            xSemaphoreGive(s_sec_mutex);
            yd_sec_wipe(p.buf, p.len);   /* 平文の控えを残さない */
            if (!live) {
                g_ydl_stats.tx_dropped++;
                continue;
            }
            if (n < 0) {
                g_ydl_stats.tx_dropped++;
                close_conn(p.gen, 0, YD_L("Encryption failed", "暗号化に失敗"));
                continue;
            }
            buf = out;
            len = (uint16_t)n;
        }
        int rc = BLE_HS_ENOTCONN;
        bool gone = false;
        for (int retry = 0; retry < 200; retry++) {      /* 送信バッファが空くまで最大約400ms */
            /* 世代の確認と送信をまとめて排他する。途中で切断・再接続されても別の接続には送らず、
             * 切ると決めた後は送らない（後続の通し番号を相手に送らない） */
            xSemaphoreTake(s_link_mutex, portMAX_DELAY);
            gone = (p.gen != s_gen || s_closing);
            rc = gone ? BLE_HS_ENOTCONN : send_one(p.conn, buf, len);
            xSemaphoreGive(s_link_mutex);
            if (rc != BLE_HS_ENOMEM && rc != BLE_HS_EBUSY) {
                break;
            }
            vTaskDelay(pdMS_TO_TICKS(2) ? pdMS_TO_TICKS(2) : 1);   /* 100Hz tickでも必ず1tick待つ */
        }
        if (rc == 0) {
            if (p.kind != PK_RAW) {
                g_ydl_stats.tx_frames++;
            }
        } else if (gone) {
            g_ydl_stats.tx_dropped++;    /* 切れた・切ると決めた接続の分 */
        } else {
            g_ydl_stats.tx_dropped++;
            ESP_LOGW(TAG, YD_L("Send failed rc=%d", "送信失敗 rc=%d"), rc);
            /* データ: 通し番号を使ったのに届かなかった。相手は抜けを改ざんとみなすので、先につなぎ直す。
             * ハンドシェイク: このままでは時間切れ（＝失敗扱い）になるので、失敗の印を付けずにつなぎ直す */
            close_conn(p.gen, 0, p.kind == PK_RAW ? YD_L("A handshake packet could not be sent", "ハンドシェイクのパケットを送れませんでした")
                                                  : YD_L("A packet could not be sent", "パケットを送れませんでした"));
        }
    }
}

/* any_conn なら、いまの接続に送る。そうでなければ conn の接続がまだ続いているときだけ */
static esp_err_t ble_send(bool any_conn, uint32_t conn, uint8_t ch, const uint8_t *data, uint16_t len)
{
    if (!s_txq) {
        return ESP_ERR_INVALID_STATE;
    }
    if (len > BLE_PKT_MAX - 1 - YD_SEC_OVERHEAD - YD_SEC_PAD_MIN) {   /* 16bit の足し算があふれる前に弾く */
        ESP_LOGE(TAG, YD_L("Payload too large len=%u", "ペイロードが大きすぎます len=%u"), len);
        return ESP_ERR_INVALID_SIZE;
    }
    pkt_t p = { .kind = PK_DATA, .len = len + 1 };
    if (!link_snapshot(&p.conn, &p.gen) || (!any_conn && p.gen != conn)) {
        return ESP_ERR_INVALID_STATE;   /* 相互認証の済んだ接続がない、または conn の接続はもう切れた */
    }
    size_t cap = wire_cap(p.conn);
    if (yd_sec_sealed_len((size_t)len + 1, cap) == 0) {
        ESP_LOGE(TAG, YD_L("Payload too large len=%u mtu=%u", "ペイロードが大きすぎます len=%u mtu=%u"), len, (unsigned)(cap + 3));
        return ESP_ERR_INVALID_SIZE;
    }
    p.buf[0] = ch;
    memcpy(&p.buf[1], data, len);
    cp_on_traffic();
    esp_err_t err = xQueueSend(s_txq, &p, pdMS_TO_TICKS(50)) == pdTRUE ? ESP_OK : ESP_ERR_TIMEOUT;
    /* 平文の控えを残さない。キューの中の写しは、tx_task が取り出したあとも次に使われるまで残る（SECURITY.md） */
    yd_sec_wipe(&p, sizeof(p));
    return err;
}

esp_err_t ydl_ble_send(uint8_t ch, const uint8_t *data, uint16_t len)
{
    return ble_send(true, 0, ch, data, len);
}

esp_err_t ydl_ble_send_on(uint32_t conn, uint8_t ch, const uint8_t *data, uint16_t len)
{
    return ble_send(false, conn, ch, data, len);
}

uint16_t ydl_ble_max_payload(void)
{
    if (!s_up) {
        return 0;
    }
    size_t wire = wire_cap(s_conn);
    return wire > 1 + YD_SEC_OVERHEAD + YD_SEC_PAD_MIN ? (uint16_t)(wire - 1 - YD_SEC_OVERHEAD - YD_SEC_PAD_MIN) : 0;
}

bool ydl_ble_is_up(void)
{
    return s_up;
}

uint32_t ydl_ble_conn_id(void)
{
    /* rx_task（rx_cb の中）では、いま渡しているデータの接続。s_gen はもう次に進んでいることがある */
    return xTaskGetCurrentTaskHandle() == s_rx_task ? s_hs_gen : s_gen;
}

esp_err_t ydl_ble_forget_peers(void)
{
    s_stash.active = false;          /* 消したボンドを、切断のときに書き戻さない */
    ble_store_clear();
    nvs_handle_t h;
    if (nvs_open("yd_link", NVS_READWRITE, &h) == ESP_OK) {
        nvs_erase_all(h);
        nvs_commit(h);
        nvs_close(h);
    }
    s_have_target = false;
    ESP_LOGW(TAG, YD_L("Pairing data erased", "ペアリング情報を消去しました"));
    if (s_conn != BLE_HS_CONN_HANDLE_NONE) {
        ble_gap_terminate(s_conn, BLE_ERR_REM_USER_CONN_TERM);
    }
    return ESP_OK;
}

/* ======================================================================
 *  Peripheral（机上ユニット）
 * ====================================================================== */
static int gap_event_periph(struct ble_gap_event *event, void *arg);

static int chr_access(uint16_t conn_handle, uint16_t attr_handle, struct ble_gatt_access_ctxt *ctxt, void *arg)
{
    if (ctxt->op == BLE_GATT_ACCESS_OP_WRITE_CHR && attr_handle == s_to_desk_val) {
        if (!s_ready) {
            return BLE_ATT_ERR_INSUFFICIENT_ENC;
        }
        push_rx(ctxt->om);
        cp_on_traffic();   /* レシーバーから要求が来た → 低遅延パラメータへ */
        return 0;
    }
    return BLE_ATT_ERR_UNLIKELY;
}

static const struct ble_gatt_svc_def s_svcs[] = {
    {
        .type = BLE_GATT_SVC_TYPE_PRIMARY,
        .uuid = &UUID_SVC.u,
        .characteristics = (struct ble_gatt_chr_def[]) {
            {
                .uuid = &UUID_TO_DESK.u,
                .access_cb = chr_access,
                .flags = BLE_GATT_CHR_F_WRITE_NO_RSP | BLE_GATT_CHR_F_WRITE_ENC,
                .val_handle = &s_to_desk_val,
            },
            {
                .uuid = &UUID_TO_RECV.u,
                .access_cb = chr_access,
                .flags = BLE_GATT_CHR_F_NOTIFY,
                .val_handle = &s_to_recv_val,
            },
            { 0 },
        },
    },
    { 0 },
};

static void periph_advertise(void)
{
    struct ble_hs_adv_fields f = { 0 };
    f.flags = BLE_HS_ADV_F_DISC_GEN | BLE_HS_ADV_F_BREDR_UNSUP;
    f.uuids128 = (ble_uuid128_t *)&UUID_SVC;
    f.num_uuids128 = 1;
    f.uuids128_is_complete = 1;
    int rc = ble_gap_adv_set_fields(&f);
    if (rc) {
        ESP_LOGE(TAG, "adv fields rc=%d", rc);
        return;
    }
    /* 名前は出さない（スキャン応答なし） */

    struct ble_gap_adv_params p = { 0 };
    p.conn_mode = BLE_GAP_CONN_MODE_UND;
    p.disc_mode = BLE_GAP_DISC_MODE_GEN;
    p.itvl_min = BLE_GAP_ADV_ITVL_MS(100);
    p.itvl_max = BLE_GAP_ADV_ITVL_MS(150);
    rc = ble_gap_adv_start(s_own_addr_type, NULL, BLE_HS_FOREVER, &p, gap_event_periph, NULL);
    if (rc && rc != BLE_HS_EALREADY) {
        ESP_LOGE(TAG, "adv start rc=%d", rc);
    } else {
        ESP_LOGI(TAG, YD_L("Advertising... (accepting new pairing: %s)", "アドバタイズ中…（新規ペアリング受付: %s）"), pairing_window_open() ? YD_L("yes", "可") : YD_L("no", "不可"));
    }
}

static void stash_clear(void)
{
    s_stash.active = false;
    yd_sec_wipe(&s_stash, sizeof(s_stash));    /* LTK を残さない */
}

/* addr の古いボンドを退避する。読めなければ false（書き戻せないものは消さない） */
static bool stash_save(const ble_addr_t *addr, uint32_t gen)
{
    struct ble_store_key_sec key = { .peer_addr = *addr };
    stash_clear();
    if (ble_store_read_our_sec(&key, &s_stash.our) != 0 || ble_store_read_peer_sec(&key, &s_stash.peer) != 0) {
        stash_clear();
        return false;
    }
    struct ble_store_key_cccd ck = { .peer_addr = *addr, .chr_val_handle = s_to_recv_val };
    s_stash.have_cccd = ble_store_read_cccd(&ck, &s_stash.cccd) == 0;
    s_stash.addr = *addr;
    s_stash.gen = gen;
    s_stash.active = true;
    return true;
}

/* 退避したボンドを書き戻す。同じアドレスに残っているもの（途中までのペアリングなど）を先に消す */
static void stash_restore(void)
{
    ble_store_util_delete_peer(&s_stash.addr);
    int rc = ble_store_write_our_sec(&s_stash.our);
    if (rc == 0) {
        rc = ble_store_write_peer_sec(&s_stash.peer);
    }
    if (rc == 0 && s_stash.have_cccd) {
        rc = ble_store_write_cccd(&s_stash.cccd);
    }
    if (rc != 0) {
        ESP_LOGE(TAG, YD_L("Could not restore the bond replaced by re-pairing rc=%d. Hold BOOT for 3 s on both units and pair them again",
                           "再ペアリングで置き換えたペアリング情報を書き戻せませんでした rc=%d。2台の BOOT を3秒押して、ペアリングし直してください"),
                 rc);
        ble_store_util_delete_peer(&s_stash.addr);   /* 半分だけ書けた状態を残さない */
    }
    print_addr(rc == 0 ? YD_L("The re-paired peer did not authenticate: restored the previous bond:", "再ペアリングした相手が相互認証を通らなかったので、前のペアリング情報に戻しました:")
                       : YD_L("Peer:", "相手:"),
               &s_stash.addr);
    stash_clear();
}

/* 接続した（ホストタスク）。新しい世代を始め、この接続の前からボンドがあった相手かを覚えておく */
static void conn_begin(uint16_t conn)
{
    struct ble_gap_conn_desc desc;
    link_begin(conn);
    s_conn_was_bonded = ble_gap_conn_find(conn, &desc) == 0 && peer_is_bonded(&desc.peer_id_addr);
    timer_arm(s_conn_timer, &s_conn_timer_gen, &s_conn_timer_due_us, s_gen, CONN_AUTH_TIMEOUT_MS);
}

/* 切れた（ホストタスク）。世代を進め、認証前に失敗した相手などの BLE ボンドを消す */
static void conn_end(void)
{
    bool authed = false, key_mismatch = false;
    uint32_t gen = link_end(&authed, &key_mismatch);
    yd_bond_conn_t c = {
        .peer_known = s_peer_addr_valid,
        .bonded_before_conn = s_conn_was_bonded,
        .authed = authed,
        .key_mismatch = key_mismatch,
    };
    esp_timer_stop(s_conn_timer);
    if (yd_bond_forget_on_disconnect(&c)) {
        int rc = ble_store_util_delete_peer(&s_peer_addr);
        if (rc != 0 && rc != BLE_HS_ENOENT) {
            s_bond_delete_fail++;
            ESP_LOGE(TAG, YD_L("Could not delete the peer's bond rc=%d (%" PRIu32 " times). Hold BOOT for 3 s to erase all pairing data",
                               "相手のペアリング情報を消せませんでした rc=%d（%" PRIu32 "回目）。BOOT を3秒押すと全部消せます"),
                     rc, s_bond_delete_fail);
            print_addr(YD_L("Peer:", "相手:"), &s_peer_addr);
        } else {
            print_addr(c.key_mismatch ? YD_L("Deleted the bond of a peer with a different key:", "鍵の違う相手のペアリング情報を消しました:")
                                     : YD_L("Deleted the bond of a peer that paired but disconnected before authenticating:", "ペアリングだけして認証前に切れた相手のペアリング情報を消しました:"),
                       &s_peer_addr);
        }
    }
    s_conn_was_bonded = false;
    /* この接続で作ったボンドを上で消してから、退避したボンドを書き戻す */
    switch (yd_bond_stash_on_disconnect(s_stash.active, s_stash.gen == gen, authed)) {
    case YD_STASH_RESTORE:
        stash_restore();
        break;
    case YD_STASH_DISCARD:
        print_addr(YD_L("The re-paired peer authenticated: keeping its new bond:", "再ペアリングした相手が相互認証を通ったので、新しいペアリング情報を使います:"), &s_stash.addr);
        stash_clear();
        break;
    case YD_STASH_NOTHING:
        break;
    }
}

/* ボンドの保存先がいっぱいのとき。NimBLE 標準の ble_store_util_status_rr は一番古い相手を
 * 消して場所を空けるが、それだと受付時間中にペアリングを繰り返すだけで、正規の相手を
 * 追い出せてしまう。ここでは古い相手を消さず、新しい保存のほうを失敗させる */
static int store_status_cb(struct ble_store_status_event *event, void *arg)
{
    switch (event->event_code) {
    case BLE_STORE_EVENT_OVERFLOW:
        ESP_LOGW(TAG, YD_L("Bond storage is full (obj_type=%d). Existing peers are kept and this bond is not saved. ", "ペアリング情報の保存先がいっぱいです（obj_type=%d）。古い相手は消さず、今回の保存をあきらめます。")
                      YD_L("To replace a peer, hold BOOT for 3 s to erase the pairing data", "相手を入れ替えるときは BOOT を3秒押してペアリング情報を消してください"),
                 event->overflow.obj_type);
        return BLE_HS_ESTORE_CAP;
    case BLE_STORE_EVENT_FULL:
        return 0;
    default:
        return BLE_HS_EUNKNOWN;
    }
}

static int gap_event_periph(struct ble_gap_event *event, void *arg)
{
    struct ble_gap_conn_desc desc;
    switch (event->type) {
    case BLE_GAP_EVENT_CONNECT:
        if (event->connect.status != 0) {
            periph_advertise();
            return 0;
        }
        conn_begin(event->connect.conn_handle);
        s_encrypted = false;
        s_subscribed = false;
        cp_reset(false);
        log_conn_params(YD_L("Connection parameters (initial):", "接続パラメータ（初期）:"), s_conn);
        if (ble_gap_conn_find(s_conn, &desc) == 0) {
            print_addr(YD_L("Connected:", "接続:"), &desc.peer_id_addr);
            if (!pairing_window_open() && !peer_is_bonded(&desc.peer_id_addr)) {
                ESP_LOGW(TAG, YD_L("Unknown peer outside the pairing window: disconnecting", "未登録の相手です。ペアリング受付時間外のため切断します"));
                ble_gap_terminate(s_conn, BLE_ERR_REM_USER_CONN_TERM);
            }
        }
        return 0;

    case BLE_GAP_EVENT_DISCONNECT:
        ESP_LOGI(TAG, YD_L("Disconnected reason=0x%x", "切断 reason=0x%x"), event->disconnect.reason);
        conn_end();
        s_encrypted = false;
        s_subscribed = false;
        transport_ready(false);
        cp_reset(false);
        periph_advertise();
        return 0;

    case BLE_GAP_EVENT_ENC_CHANGE:
        if (event->enc_change.status == 0 && ble_gap_conn_find(event->enc_change.conn_handle, &desc) == 0) {
            s_encrypted = desc.sec_state.encrypted;
            ESP_LOGI(TAG, YD_L("Encryption %s (bonded=%d)", "暗号化 %s（bonded=%d）"), s_encrypted ? "OK" : "NG", desc.sec_state.bonded);
            link_set_peer(&desc.peer_id_addr);
            /* ボンディング済みの相手は購読状態が復元済みのことがある */
            if (s_encrypted && s_subscribed) {
                transport_ready(true);
            }
        } else {
            ESP_LOGW(TAG, YD_L("Encryption failed status=%d", "暗号化失敗 status=%d"), event->enc_change.status);
        }
        return 0;

    case BLE_GAP_EVENT_SUBSCRIBE:
        if (event->subscribe.attr_handle == s_to_recv_val) {
            s_subscribed = event->subscribe.cur_notify;
            if (s_subscribed && s_encrypted) {
                transport_ready(true);
            } else if (!s_subscribed) {
                transport_ready(false);
            }
        }
        return 0;

    case BLE_GAP_EVENT_MTU:
        ESP_LOGI(TAG, "MTU=%d", event->mtu.value);
        return 0;

    case BLE_GAP_EVENT_CONN_UPDATE: {
        bool ok = (event->conn_update.status == 0);
        bool idle_now = s_cp_idle;
        if (ok && ble_gap_conn_find(event->conn_update.conn_handle, &desc) == 0) {
            idle_now = desc.conn_latency > 0;
        }
        portENTER_CRITICAL(&s_cp_mux);
        s_cp_pending = false;
        s_cp_idle = idle_now;
        if (!ok) {
            s_cp_retry_at_us = esp_timer_get_time() + (int64_t)CP_RETRY_MS * 1000;
        }
        portEXIT_CRITICAL(&s_cp_mux);
        if (ok) {
            log_conn_params(idle_now ? YD_L("Connection parameters updated (power save):", "接続パラメータ更新完了（省電力）:") : YD_L("Connection parameters updated (low latency):", "接続パラメータ更新完了（低遅延）:"),
                            event->conn_update.conn_handle);
        } else {
            ESP_LOGW(TAG, YD_L("Connection parameter update failed status=%d (retry in %d s)", "接続パラメータ更新に失敗 status=%d（%d秒後に再試行）"), event->conn_update.status, CP_RETRY_MS / 1000);
        }
        /* 手続き中に通信が始まっていたら、すぐ低遅延へ戻す */
        cp_eval();
        return 0;
    }

    case BLE_GAP_EVENT_CONN_UPDATE_REQ:
        /* レシーバー側から変更要求が来た場合はそのまま受け入れる */
        ESP_LOGI(TAG, YD_L("Peer requested connection parameters: interval %u-%u latency %u timeout %u", "相手から接続パラメータ変更要求: interval %u-%u latency %u timeout %u"),
                 event->conn_update_req.peer_params->itvl_min, event->conn_update_req.peer_params->itvl_max,
                 event->conn_update_req.peer_params->latency, event->conn_update_req.peer_params->supervision_timeout);
        return 0;

    case BLE_GAP_EVENT_REPEAT_PAIRING:
        /* 古いボンドは退避してから消し、この接続が相互認証を通らなければ conn_end で書き戻す。レシーバーの
         * アドレスを名乗るだけの機器に、本物のボンドを消させない（yd_bond_policy.h） */
        if (yd_bond_on_repeat_pairing(pairing_window_open(), s_stash.active) == YD_REPEAT_REFUSE) {
            if (s_stash.active) {
                ESP_LOGW(TAG, YD_L("Re-pairing request rejected (already re-pairing on this connection)", "再ペアリング要求を拒否（この接続で再ペアリング中）"));
            } else {
                ESP_LOGW(TAG, YD_L("Re-pairing request rejected (outside the pairing window)", "再ペアリング要求を拒否（受付時間外）"));
            }
            return BLE_GAP_REPEAT_PAIRING_IGNORE;
        }
        if (ble_gap_conn_find(event->repeat_pairing.conn_handle, &desc) != 0 || !stash_save(&desc.peer_id_addr, s_gen)) {
            ESP_LOGW(TAG, YD_L("Re-pairing request rejected (could not save the previous bond)", "再ペアリング要求を拒否（前のペアリング情報を退避できない）"));
            return BLE_GAP_REPEAT_PAIRING_IGNORE;
        }
        ble_store_util_delete_peer(&desc.peer_id_addr);
        s_conn_was_bonded = false;   /* この接続で作り直すボンドは、相互認証を通らなければ消える */
        return BLE_GAP_REPEAT_PAIRING_RETRY;

    case BLE_GAP_EVENT_ADV_COMPLETE:
        periph_advertise();
        return 0;

    case BLE_GAP_EVENT_NOTIFY_TX:
        /* 通知を送った tx_task の中から、s_link_mutex を持ったまま同期で呼ばれる。ここでロックを取らない */
        return 0;
    }
    return 0;
}

/* ======================================================================
 *  Central（レシーバー）
 * ====================================================================== */
static int gap_event_central(struct ble_gap_event *event, void *arg);

static void central_scan(void)
{
    struct ble_gap_disc_params dp = { 0 };
    dp.filter_duplicates = 1;
    dp.passive = 1;
    int rc = ble_gap_disc(s_own_addr_type, BLE_HS_FOREVER, &dp, gap_event_central, NULL);
    if (rc && rc != BLE_HS_EALREADY) {
        ESP_LOGE(TAG, "scan start rc=%d", rc);
    } else {
        ESP_LOGI(TAG, YD_L("Scanning for the desk unit...%s", "机上ユニットを探しています…%s"), s_have_target ? YD_L(" (registered unit only)", "（登録済みの相手のみ）") : YD_L(" (first pairing)", "（初回ペアリング）"));
    }
}

static bool adv_has_uuid(const struct ble_gap_disc_desc *d, const ble_uuid128_t *uuid)
{
    struct ble_hs_adv_fields f;
    if (ble_hs_adv_parse_fields(&f, d->data, d->length_data) != 0) {
        return false;
    }
    for (int i = 0; i < f.num_uuids128; i++) {
        if (ble_uuid_cmp(&f.uuids128[i].u, &uuid->u) == 0) {
            return true;
        }
    }
    return false;
}

static bool adv_has_our_svc(const struct ble_gap_disc_desc *d)
{
    return adv_has_uuid(d, &UUID_SVC);
}

/* 自分の UUID を出していない広告のうち、古い版の机上ユニット（固定の UUID）か、登録済みの机上ユニットの
 * アドレスのものなら、つながらない理由をログに出す（30秒に1回まで）。UUID が PSK から作られるので、
 * 版や鍵の違う机上ユニットとは接続して確かめることができないため */
static void hint_unmatched_adv(const struct ble_gap_disc_desc *d)
{
    static int64_t last_us;
    bool legacy = adv_has_uuid(d, &UUID_LEGACY_SVC);
    bool target = s_have_target && ble_addr_cmp(&d->addr, &s_target) == 0;
    int64_t now = esp_timer_get_time();
    if ((!legacy && !target) || (last_us && now - last_us < 30 * 1000000LL)) {
        return;
    }
    last_us = now;
    if (legacy) {
        ESP_LOGW(TAG, YD_L("A desk unit with older KeyRelay firmware (fixed service UUID) is advertising nearby. "
                           "Older and newer firmware do not see each other: update it",
                           "古い版の KeyRelay の机上ユニット（固定のサービス UUID）が近くでアドバタイズしています。"
                           "古い版と新しい版は互いに見えないので、机上ユニットを更新してください"));
        print_addr(YD_L("Address:", "アドレス:"), &d->addr);
    } else {
        ESP_LOGW(TAG, YD_L("The registered desk unit is advertising, but not with this unit's Link ID: it has a different "
                           "key file (or other firmware). Compare the Link ID lines in both logs",
                           "登録済みの机上ユニットがアドバタイズしていますが、このレシーバーのリンク ID ではありません。"
                           "鍵ファイル（またはファームの版）が違います。2台のログのリンク ID を見比べてください"));
    }
}

static void central_connect(const ble_addr_t *addr)
{
    if (ble_gap_disc_cancel() != 0) {
        /* すでに止まっていてもOK */
    }
    struct ble_gap_conn_params cp = {
        .scan_itvl = 0x10, .scan_window = 0x10,
        .itvl_min = BLE_GAP_CONN_ITVL_MS(15), .itvl_max = BLE_GAP_CONN_ITVL_MS(30),
        .latency = 0,
        .supervision_timeout = BLE_GAP_SUPERVISION_TIMEOUT_MS(4000),
        .min_ce_len = 0, .max_ce_len = 0,
    };
    print_addr(YD_L("Connecting to:", "接続を試みます:"), addr);
    int rc = ble_gap_connect(s_own_addr_type, addr, 10000, &cp, gap_event_central, NULL);
    if (rc) {
        ESP_LOGW(TAG, "connect rc=%d", rc);
        central_scan();
    }
}

static int on_cccd_written(uint16_t conn, const struct ble_gatt_error *err, struct ble_gatt_attr *attr, void *arg)
{
    if (err->status == 0) {
        transport_ready(true);
    } else {
        ESP_LOGE(TAG, YD_L("Notification subscription failed status=%d", "通知の購読に失敗 status=%d"), err->status);
        ble_gap_terminate(conn, BLE_ERR_REM_USER_CONN_TERM);
    }
    return 0;
}

static int on_chr(uint16_t conn, const struct ble_gatt_error *err, const struct ble_gatt_chr *chr, void *arg)
{
    if (err->status == 0) {
        if (ble_uuid_cmp(&chr->uuid.u, &UUID_TO_DESK.u) == 0) {
            s_peer_to_desk = chr->val_handle;
        } else if (ble_uuid_cmp(&chr->uuid.u, &UUID_TO_RECV.u) == 0) {
            s_peer_to_recv = chr->val_handle;
        }
        return 0;
    }
    if (err->status == BLE_HS_EDONE) {
        if (!s_peer_to_desk || !s_peer_to_recv) {
            ESP_LOGE(TAG, YD_L("Characteristic not found", "キャラクタリスティックが見つかりません"));
            ble_gap_terminate(conn, BLE_ERR_REM_USER_CONN_TERM);
            return 0;
        }
        /* NimBLEのGATTサーバーでは CCCD は Notify値ハンドルの直後に置かれる */
        static const uint8_t on[2] = { 0x01, 0x00 };
        ble_gattc_write_flat(conn, s_peer_to_recv + 1, on, sizeof(on), on_cccd_written, NULL);
        return 0;
    }
    ESP_LOGE(TAG, YD_L("Characteristic discovery error %d", "キャラクタリスティック探索エラー %d"), err->status);
    ble_gap_terminate(conn, BLE_ERR_REM_USER_CONN_TERM);
    return 0;
}

static int on_svc(uint16_t conn, const struct ble_gatt_error *err, const struct ble_gatt_svc *svc, void *arg)
{
    if (err->status == 0) {
        s_svc_start = svc->start_handle;
        s_svc_end = svc->end_handle;
        return 0;
    }
    if (err->status == BLE_HS_EDONE && s_svc_start) {
        ble_gattc_disc_all_chrs(conn, s_svc_start, s_svc_end, on_chr, NULL);
        return 0;
    }
    ESP_LOGE(TAG, YD_L("Service not found %d", "サービスが見つかりません %d"), err->status);
    ble_gap_terminate(conn, BLE_ERR_REM_USER_CONN_TERM);
    return 0;
}

static int on_mtu(uint16_t conn, const struct ble_gatt_error *err, uint16_t mtu, void *arg)
{
    ESP_LOGI(TAG, "MTU=%u", mtu);
    return 0;
}

static int gap_event_central(struct ble_gap_event *event, void *arg)
{
    struct ble_gap_conn_desc desc;
    switch (event->type) {
    case BLE_GAP_EVENT_DISC:
        if (!adv_has_our_svc(&event->disc)) {
            hint_unmatched_adv(&event->disc);
            return 0;
        }
        if (s_have_target && !is_target(&event->disc.addr)) {
            return 0;   /* 登録済みの机上ユニット以外は無視 */
        }
        central_connect(&event->disc.addr);
        return 0;

    case BLE_GAP_EVENT_DISC_COMPLETE:
        central_scan();
        return 0;

    case BLE_GAP_EVENT_CONNECT:
        if (event->connect.status != 0) {
            ESP_LOGW(TAG, YD_L("Connection failed status=%d", "接続失敗 status=%d"), event->connect.status);
            central_scan();
            return 0;
        }
        conn_begin(event->connect.conn_handle);
        s_encrypted = false;
        s_svc_start = s_svc_end = s_peer_to_desk = s_peer_to_recv = 0;
        ble_gattc_exchange_mtu(s_conn, on_mtu, NULL);
        /* 既存の鍵があれば暗号化、なければペアリング */
        ble_gap_security_initiate(s_conn);
        return 0;

    case BLE_GAP_EVENT_DISCONNECT:
        ESP_LOGI(TAG, YD_L("Disconnected reason=0x%x", "切断 reason=0x%x"), event->disconnect.reason);
        /* 古い版の机上ユニット（固定の UUID）は、もう見つけて接続することがないので、ここでの版のヒントは不要
         * （見つけたときは hint_unmatched_adv が知らせる） */
        conn_end();
        s_encrypted = false;
        transport_ready(false);
        central_scan();
        return 0;

    case BLE_GAP_EVENT_ENC_CHANGE:
        if (event->enc_change.status == 0 && ble_gap_conn_find(event->enc_change.conn_handle, &desc) == 0) {
            s_encrypted = desc.sec_state.encrypted;
            ESP_LOGI(TAG, YD_L("Encryption %s (bonded=%d)", "暗号化 %s（bonded=%d）"), s_encrypted ? "OK" : "NG", desc.sec_state.bonded);
            link_set_peer(&desc.peer_id_addr);
            if (!s_have_target) {
                print_addr(YD_L("First peer (registered once key authentication succeeds):", "初回の相手（鍵の相互認証が通ったら登録します）:"), &desc.peer_id_addr);
            }
            ble_gattc_disc_svc_by_uuid(s_conn, &UUID_SVC.u, on_svc, NULL);
        } else {
            ESP_LOGW(TAG, YD_L("Encryption failed status=%d (the peer may have lost its bond)", "暗号化失敗 status=%d（相手が鍵を失った可能性）"), event->enc_change.status);
            if (ble_gap_conn_find(event->enc_change.conn_handle, &desc) == 0) {
                if (is_target(&desc.peer_id_addr)) {
                    /* 登録済みの机上ユニットのボンドは消さない。アドレスは偽装できるので、鍵を持たない機器が
                     * 暗号化をわざと失敗させるだけで、本物とのボンドを消せてしまう（本物は受付時間外なので
                     * ペアリングし直さず、つながらなくなる） */
                    ESP_LOGW(TAG, YD_L("Keeping the registered desk unit's bond. If the desk unit's pairing data was erased, "
                                       "hold BOOT on this receiver for 3 s too",
                                       "登録済みの机上ユニットのペアリング情報は残します。机上ユニットのペアリング情報を消したときは、"
                                       "このレシーバーの BOOT も3秒押してください"));
                } else {
                    ble_store_util_delete_peer(&desc.peer_id_addr);
                }
            }
            ble_gap_terminate(event->enc_change.conn_handle, BLE_ERR_REM_USER_CONN_TERM);
        }
        return 0;

    case BLE_GAP_EVENT_NOTIFY_RX:
        /* ハンドシェイク中のHELLO/AUTHも受け取る（判定は on_packet）。
         * ボンディング済みの相手は購読状態が復元されるので、こちらがサービス探索を終える前に
         * 机上ユニットのHELLOが届くことがある → ハンドル未確定の間は（indication以外の）通知を受け入れる */
        if (s_encrypted && !event->notify_rx.indication &&
            (event->notify_rx.attr_handle == s_peer_to_recv || s_peer_to_recv == 0)) {
            push_rx(event->notify_rx.om);
        }
        return 0;

    case BLE_GAP_EVENT_MTU:
        ESP_LOGI(TAG, "MTU=%d", event->mtu.value);
        return 0;

    /* 机上ユニット（Peripheral）からの接続パラメータ変更要求は、そのまま受け入れる。
     * 0 を返すと NimBLE は相手の希望値で承認する（こちらから別の値を押し付けない） */
    case BLE_GAP_EVENT_CONN_UPDATE_REQ:
        ESP_LOGI(TAG, YD_L("Desk unit requested connection parameters: interval %u-%u(x1.25ms) latency %u timeout %u(x10ms) → accepted", "机上ユニットから接続パラメータ変更要求: interval %u-%u(×1.25ms) latency %u timeout %u(×10ms) → 承認"),
                 event->conn_update_req.peer_params->itvl_min, event->conn_update_req.peer_params->itvl_max,
                 event->conn_update_req.peer_params->latency, event->conn_update_req.peer_params->supervision_timeout);
        return 0;

    case BLE_GAP_EVENT_L2CAP_UPDATE_REQ:
        ESP_LOGI(TAG, YD_L("Desk unit requested connection parameters (L2CAP): interval %u-%u latency %u → accepted", "机上ユニットから接続パラメータ変更要求(L2CAP): interval %u-%u latency %u → 承認"),
                 event->conn_update_req.peer_params->itvl_min, event->conn_update_req.peer_params->itvl_max,
                 event->conn_update_req.peer_params->latency);
        return 0;

    case BLE_GAP_EVENT_CONN_UPDATE:
        if (event->conn_update.status == 0) {
            log_conn_params(YD_L("Connection parameters updated:", "接続パラメータ更新:"), event->conn_update.conn_handle);
        } else {
            ESP_LOGW(TAG, YD_L("Connection parameter update failed status=%d", "接続パラメータ更新に失敗 status=%d"), event->conn_update.status);
        }
        return 0;

    case BLE_GAP_EVENT_REPEAT_PAIRING:
        if (ble_gap_conn_find(event->repeat_pairing.conn_handle, &desc) != 0) {
            return BLE_GAP_REPEAT_PAIRING_IGNORE;
        }
        if (is_target(&desc.peer_id_addr)) {
            /* 上の暗号化の失敗と同じ理由で、登録済みの机上ユニットとはペアリングし直さない */
            ESP_LOGW(TAG, YD_L("Re-pairing with the registered desk unit rejected (hold BOOT for 3 s to pair again)",
                               "登録済みの机上ユニットとの再ペアリングを拒否（ペアリングし直すときは BOOT を3秒押してください）"));
            return BLE_GAP_REPEAT_PAIRING_IGNORE;
        }
        ble_store_util_delete_peer(&desc.peer_id_addr);
        s_conn_was_bonded = false;
        return BLE_GAP_REPEAT_PAIRING_RETRY;
    }
    return 0;
}

/* ======================================================================
 *  初期化
 * ====================================================================== */
static void on_reset(int reason)
{
    ESP_LOGE(TAG, "NimBLE reset reason=%d", reason);
}

static void on_sync(void)
{
    ble_hs_util_ensure_addr(0);
    ble_hs_id_infer_auto(0, &s_own_addr_type);
    uint8_t a[6] = { 0 };
    ble_hs_id_copy_addr(s_own_addr_type, a, NULL);
    ESP_LOGI(TAG, YD_L("Own BLE address %02x:%02x:%02x:%02x:%02x:%02x (bonded peers=%d)", "自分のBLEアドレス %02x:%02x:%02x:%02x:%02x:%02x（登録済みペア数=%d）"),
             a[5], a[4], a[3], a[2], a[1], a[0], bond_count());
    if (s_is_central) {
        central_scan();
    } else {
        periph_advertise();
    }
}

static void host_task(void *param)
{
    nimble_port_run();
    nimble_port_freertos_deinit();
}

esp_err_t ydl_ble_init(const yd_link_config_t *cfg)
{
    s_cfg = *cfg;
    s_is_central = (cfg->transport == YD_LINK_BLE_CENTRAL);
    s_cp_enabled = !s_is_central && cfg->ble_conn_power_save;

    esp_err_t err = nvs_flash_init();
    if (err == ESP_ERR_NVS_NO_FREE_PAGES || err == ESP_ERR_NVS_NEW_VERSION_FOUND) {
        nvs_flash_erase();
        err = nvs_flash_init();
    }
    ESP_RETURN_ON_ERROR(err, TAG, "nvs");

    s_sec_mutex = xSemaphoreCreateMutex();
    s_link_mutex = xSemaphoreCreateMutex();
    s_state_mutex = xSemaphoreCreateMutex();
    ESP_RETURN_ON_FALSE(s_sec_mutex && s_link_mutex && s_state_mutex, ESP_ERR_NO_MEM, TAG, "mutex");
    const esp_timer_create_args_t ta = { .callback = hs_timeout_cb, .name = "yd_hs" };
    ESP_RETURN_ON_ERROR(esp_timer_create(&ta, &s_hs_timer), TAG, "timer");
    const esp_timer_create_args_t tc = { .callback = conn_timeout_cb, .name = "yd_conn" };
    ESP_RETURN_ON_ERROR(esp_timer_create(&tc, &s_conn_timer), TAG, "timer");
    s_have_psk = load_psk();
    if (s_have_psk) {
        bool ok = yd_sec_gatt_uuid(s_psk, YD_SEC_GATT_SVC, UUID_SVC.value) == 0 &&
                  yd_sec_gatt_uuid(s_psk, YD_SEC_GATT_TO_DESK, UUID_TO_DESK.value) == 0 &&
                  yd_sec_gatt_uuid(s_psk, YD_SEC_GATT_TO_RECV, UUID_TO_RECV.value) == 0;
        ESP_RETURN_ON_FALSE(ok, ESP_FAIL, TAG, "gatt uuid");
        /* 2台で同じ鍵を使っているかを見比べる手がかり（電波に出ている値の一部なので、表示しても問題ない） */
        const uint8_t *id = UUID_SVC.value;
        ESP_LOGI(TAG, YD_L("Link ID %02x%02x%02x%02x (must be the same on both units)", "リンク ID %02x%02x%02x%02x（2台で同じになるはず）"),
                 id[0], id[1], id[2], id[3]);
    }

    s_txq = xQueueCreate(TXQ_DEPTH, sizeof(pkt_t));
    s_rxq = xQueueCreate(RXQ_DEPTH, sizeof(pkt_t));
    ESP_RETURN_ON_FALSE(s_txq && s_rxq, ESP_ERR_NO_MEM, TAG, "queue");
    xTaskCreate(rx_task, "yd_ble_rx", 8192, NULL, 12, &s_rx_task);   /* X25519（mbedtls）の分も余裕を持たせる */
    xTaskCreate(tx_task, "yd_ble_tx", 4096, NULL, 12, NULL);

    if (s_is_central) {
        target_load();
    }

    if (!s_have_psk) {
        /* 鍵がなければ電波も出さない（鍵なしで動く状態を作らない） */
        ESP_LOGE(TAG, YD_L("No key: BLE is not started", "鍵がないためBLEを起動しません"));
        return ESP_OK;
    }

    ESP_RETURN_ON_ERROR(nimble_port_init(), TAG, "nimble init");

    ble_hs_cfg.reset_cb = on_reset;
    ble_hs_cfg.sync_cb = on_sync;
    ble_hs_cfg.store_status_cb = store_status_cb;
    ble_hs_cfg.sm_io_cap = BLE_HS_IO_NO_INPUT_OUTPUT;
    ble_hs_cfg.sm_bonding = 1;
    ble_hs_cfg.sm_mitm = 0;
    ble_hs_cfg.sm_sc = 1;
    ble_hs_cfg.sm_our_key_dist = BLE_SM_PAIR_KEY_DIST_ENC | BLE_SM_PAIR_KEY_DIST_ID;
    ble_hs_cfg.sm_their_key_dist = BLE_SM_PAIR_KEY_DIST_ENC | BLE_SM_PAIR_KEY_DIST_ID;

    ble_svc_gap_init();
    ble_svc_gatt_init();
    ble_svc_gap_device_name_set("");   /* 接続した相手に読まれる GAP の名前も空にする */
    ble_att_set_preferred_mtu(247);

    if (!s_is_central) {
        int rc = ble_gatts_count_cfg(s_svcs);
        ESP_RETURN_ON_FALSE(rc == 0, ESP_FAIL, TAG, "gatts count %d", rc);
        rc = ble_gatts_add_svcs(s_svcs);
        ESP_RETURN_ON_FALSE(rc == 0, ESP_FAIL, TAG, "gatts add %d", rc);
    }

    ble_store_config_init();
    nimble_port_freertos_init(host_task);
    ESP_LOGI(TAG, YD_L("BLE started (%s)", "BLE起動（%s）"), s_is_central ? YD_L("receiver / central", "レシーバー / Central") : YD_L("desk unit / peripheral", "机上ユニット / Peripheral"));
    return ESP_OK;
}
