maromocooo/keyrelay/(commit log)

2026-10-23 Initial public release of KeyRelay
    Wireless relay for a USB security key: a desk unit (XIAO ESP32S3, USB
    host) and a receiver (ESP32-S3, USB device) connected over BLE with
    LE Secure Connections and a pre-shared-key AES-256-GCM layer.
    Relays FIDO2/U2F, CCID (PIV, OpenPGP, OATH), OTP typing and OTP
    feature reports (challenge-response, slot configuration). Includes the
    parametric case for a USB-A key, build guides in English and Japanese,
    a security policy, a draft hardening guide, host unit tests (including
    known-answer and tamper tests for the link security) and a CI build.
    [keyrelay_usba_body.stl, keyrelay_usba_cover.stl, keyrelay_usba_test_touch.stl, keyrelay_usba_test_usbc_port.stl, partitions.csv]
2026-10-23 ble: forget unauthenticated new bonds, never evict bonds, reserve event slots
    - Delete a bond created during this connection when the peer disconnects
    before the PSK handshake completes, including peer-initiated
    disconnects. Existing bonds survive a radio drop before the handshake.
    The decision lives in yd_bond_policy.h with a host test.
    - Replace ble_store_util_status_rr: when the bond store overflows, refuse
    the new bond instead of evicting the oldest (legitimate) one.
    - Keep RXQ_EV_RESERVE slots of the rx queue free for connect/disconnect
    events so peer data cannot crowd them out; disconnect if an event still
    cannot be queued.
    - CI: compile only, stop uploading firmware built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
    [yd_bond_policy.h, yd_link_ble.c]
2026-10-23 logs: English by default, Japanese selectable in menuconfig
    Every log string is now YD_L("English", "日本語"), resolved at compile
    time by the new "KeyRelay log language" choice (components/yd_link/
    Kconfig, default English). CI also builds both projects with Japanese
    logs.
    [ccid_dev.c, ccid_host.c, hid_dev.c, main.c, otp_host.c, yd_frag.c, yd_lang.h, yd_link_ble.c]
2026-10-24 ble: connection-level auth timeout, check AUTH MAC errors and bond deletion
    - Close any connection that has not completed the PSK handshake 15 s
    after it was opened. The 5 s handshake timer only starts once the link
    is encrypted and subscribed, so a peer that never encrypts or never
    subscribes could hold the single connection slot indefinitely.
    - yd_sec_auth_mac: zero the output when HMAC fails instead of copying
    uninitialised stack; hs_progress aborts the handshake on that error.
    - Log (and count) a failed bond deletion instead of reporting success.
    [yd_link_ble.c, yd_sec.c]
2026-10-24 link protocol v2: X25519 forward secrecy, padding, strict counters
    - HELLO now carries a fresh X25519 public key. Per-connection keys use
    HKDF-SHA256 over PSK || X25519 secret, salted with both nonces and both
    public keys. Private keys stay in RAM and are wiped after derivation, so
    a later readout of the PSK and BLE bonds no longer decrypts recordings.
    Low-order public keys are rejected.
    - Plaintext is padded (0x80, zeros) to 32-byte multiples so packet sizes
    do not reveal PIN lengths.
    - Data counters must increase by exactly one; reordered, replayed and
    dropped packets end the connection. A packet lost to a full local queue
    or a failed send reconnects without marking the peer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
    [yd_link_ble.c, yd_sec.c, yd_sec.h]
2026-10-24 otp: Yubico OTP key filter on the receiver, fixed send schedule per touch
    - The receiver types only ModHex letters and Enter without modifiers by
    default (CONFIG_YD_OTP_KBD_FILTER_MODHEX), so a fake desk unit holding
    a stolen PSK cannot type commands. "Any key" is available for static
    passwords, OATH-HOTP and Tab options. Blocked reports are logged.
    - Key reports are dropped unless the desk unit announced an OTP keyboard,
    queued without blocking the BLE receive task, and repeated release
    reports are collapsed.
    - The desk unit buffers key reports and a dedicated task sends one packet
    of the same size every 50 ms for at least 2 s per touch, each cut at a
    release, so neither sizes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
    [hid_dev.c, otp_batch.h, otp_host.c]
2026-10-24 docs: PSK compromise, fake desk unit, radio metadata, NFC, attestation, EUCLEAK
    - New "If the PSK leaks" section: forward secrecy for past traffic, the
    fake desk unit (keystroke) direction, and what a fake receiver can do
    without a touch or PIN (OATH without password or touch, challenge-
    response without touch, PIN lockout). Corrects the earlier claim that a
    PIN and touch are always needed.
    - Describe protocol v2, padding, the OTP send schedule and strict
    counters; what the radio still shows; turning off NFC; attestation and
    employer policies; YSA-2024-03.
    - BUILD: keyboard filter, NFC, update both units (desk unit first).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
2026-10-24 hardening: build configuration, signing/encryption script, rewritten guide
    - firmware/hardening/: sdkconfig fragment (secure boot v2, flash
    encryption release mode, secure download mode, NVS encryption),
    partition table with the table at 0x10000 (the signed secure boot
    bootloader is ~44 KB) and an nvs_keys partition, and make_images.sh to
    sign and encrypt the images of one unit with host-generated keys.
    - docs/HARDENING.md (EN/JA): step-by-step procedure in the order of
    Espressif's enablement workflow (flash encryption eFuses, then secure
    boot, all before the first boot), checks after the first boot, updates
    and recovery. Explains why development mode is not enough. Verified by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
    [partitions_hardened.csv]
2026-10-24 hardening: verified on a receiver, document what the hardware showed
    The procedure was run end to end on a Freenove ESP32-S3 receiver (rev
    v0.2, esptool v5.6): secure boot, release-mode flash encryption, NVS
    encryption and secure download mode are active, read-flash is refused,
    and FIDO, OpenPGP and OTP work through it.
    - The firmware revokes the unused digest slots on its first boot, so the
    "optional" revoke step is not needed and the single key must be kept.
    - Expected logs and get-security-info output as observed; secure
    download mode is enabled without a log line of its own.
    - First flash uses --after no-reset so the first boot can be watched.
    - The desk unit is not yet hardened on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
2026-10-24 link: derive the GATT UUIDs from the PSK, advertise no name
    The desk unit advertised a fixed 128-bit service UUID and the name
    "KeyRelay", so a scanner could tell where a KeyRelay unit is.
    The service and the two characteristic UUIDs are now each the first 16
    bytes of HMAC-SHA256(PSK, "keyrelay v2 gatt uuid" || n), n = 0, 1, 2, so
    they show no relation to each other either. No name is advertised and
    the GAP device name is empty. Units with different keys no longer see
    each other, so both units log the first four bytes of the service UUID
    as "Link ID" at boot, and the receiver logs a hint when its registered
    desk unit, or a desk unit with older firmware (old fixed UUID), is
    advertising somet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
    [yd_link_ble.c, yd_sec.c, yd_sec.h]
2026-10-24 link: tie queued packets, handshakes and timers to their connection
    BLE connection handles are reused, so work that belonged to an old
    connection could reach the next one: a packet queued before a
    disconnect could be sealed with the next connection's keys and sent to
    it, and a handshake still being computed in rx_task (X25519 takes up to
    ~260 ms) could send its AUTH to, disconnect, or mark as authenticated
    a connection that had just replaced it. The last case could keep a
    peer without the PSK from having its bond deleted.
    Every connection now has a generation number. s_conn, the generation
    and the per-connection state (s_up, s_closing, s_conn_authed,
    s_forget_on_disconnect, the peer address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
    [yd_link_ble.c]
2026-10-24 receiver: type only OTP-shaped input by default
    The ModHex filter let any ModHex letters and Enter through, so a fake
    desk unit holding the PSK could still type a short ModHex word and
    press Enter.
    The default filter now only types input shaped like a Yubico OTP: in
    one burst, up to 64 ModHex letters without modifiers, and one Enter
    only after 32 to 64 of them. Each report may hold exactly one key, and
    the receiver types every accepted key as its own press and release and
    ignores the desk unit's releases, so the number of characters the
    computer sees is exactly what the filter counted, and holding a key
    down for the computer's key repeat does not work. Anything else blocks
    the rest of the b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
    [hid_dev.c, kbd_filter.h]
2026-10-24 docs: lost or stolen units, shared PSK, fault injection, ykman --reader
    - SECURITY: what to do when a unit is lost or stolen (erasing bonds
    does not lock out a unit that has the PSK; rotate the PSK on all the
    others), the shared-PSK design limit and per-unit keys as a possible
    next protocol version, the OTP-shaped keyboard filter, padding near
    the packet size limit, PSK-derived UUIDs, fixed Bluetooth addresses,
    plaintext left in USB and reassembly buffers.
    - HARDENING: what hardening does not stop (a stolen unit being used,
    voltage fault injection per Espressif AR2026-005, exposed
    flash-encryption keys), never paste key material anywhere, how to
    change the PSK on a hardened u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
    [main.c]
2026-10-24 link: drop the receiver's "desk unit refused our HELLO" hint
    The hint was for desk units with link protocol v1, which reject a v2
    HELLO without naming their version. Desk units with firmware that old
    advertise the fixed service UUID and are no longer found at all, so the
    hint can no longer fire for them. It could only fire misleadingly, for
    example when a desk unit with the same key hit its handshake timeout
    before replying. A desk unit with older firmware is now reported by
    hint_unmatched_adv instead.
    [yd_link_ble.c]
2026-10-24 receiver: spoil the OTP burst when a key cannot be sent to the computer
    kbd_send() gives up after 500 ms without starting the transfer, so the
    report is lost while kbd_filter has already counted it, the same way a
    full queue lost it before the previous commit. kbd_task now bumps
    s_kbd_epoch when a send fails and skips the key presses queued under the
    old value (an Enter already queued for that burst included), and
    rx_task spoils the burst in kbd_filter when it sees the new value.
    [hid_dev.c, kbd_filter.h]
2026-10-24 desk unit: reset the card before a new connection can use it
    The desk unit kept relaying CCID to the same card across BLE
    reconnections, so a PIV PIN verified on one connection (PIN policy
    once, touch policy never) could be used by the next one without
    entering it again, and a request, a half-reassembled fragment or a
    response (say, a signature that was waiting for a touch) from the old
    connection could reach the new one.
    - yd_link_conn_id(): the link's connection number. In rx_cb it is the
    connection the data arrived on. state_cb can skip a quick
    down/up, so it cannot be used for this.
    - ccid_host tags each request with its connection and drops requests
    from a closed connection, rest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
    [ccid_host.c, ccid_host.h, main.c, yd_ccid.h, yd_link.c, yd_link.h, yd_link_ble.c]
2026-10-24 desk unit: accept 'not present' as the answer to our PowerOff
    A YubiKey 5 (fw 5.1.2) answers PowerOff with bmICCStatus 2 (no ICC
    present) rather than 1 (inactive), even right after the card was in
    use. yd_ccid_power_resp treated that as a failure, so every reconnection
    fell back to restarting the key's USB bus. PowerOff now succeeds with
    the card inactive or absent; PowerOn still has to leave it active.
    [yd_ccid.h]
2026-10-24 link: send every fragment of a reply to the connection that asked
    handle_rsp checked that the CCID response belonged to the current
    connection, but yd_frag_send then sent each fragment to whatever
    connection was current at that moment. If the BLE link dropped and a new
    connection came up while a fragment was being retried on a full send
    queue, the rest of the response (up to the whole message) went to the new
    connection, i.e. to another receiver holding the PSK.
    Add yd_link_send_on(conn, ...), which only queues the packet while the
    connection identified by yd_link_conn_id() is still up; tx_task already
    drops packets of an older generation. yd_frag_send now takes that
    connection and stops at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
2026-10-24 receiver: count a key as typed only when the computer took the report
    kbd_send returned true as soon as the IN transfer was queued, whether or
    not it completed within 100 ms and whatever its result. The ModHex filter
    counts every key it lets through, so a report the computer never received
    still counted towards the 32 letters an Enter needs, and the s_kbd_epoch
    check added for send failures never ran. With 32 lost letters a short word
    and Enter could still get through.
    Record the IN transfer result in xfer_cb and return true only when the
    completion arrives in time and reports success. A transfer that completes
    after the timeout is still treated as not delivered, which spoils the
    burst rath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
    [hid_dev.c]
2026-10-24 link: stop a device without the PSK from erasing the units' bonds
    A device without the PSK could lock the receiver out of its desk unit
    until the desk unit was power-cycled: claim the desk unit's address,
    let the receiver reconnect to it and fail encryption. The receiver then
    deleted the real desk unit's bond, and the desk unit refused to pair
    again outside its 120 s window. A handshake timeout had the same effect
    without any attacker, because it deleted bonds that existed before the
    connection on one side only.
    - Receiver: never delete the registered desk unit's bond when encryption
    fails, and refuse re-pairing with it. Recovering from a desk unit that
    really lost its bond now takes BO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
    [yd_bond_policy.h, yd_link_ble.c]
2026-10-24 desk unit: block OTP commands that change the key
    The desk unit forwarded every SET_REPORT(Feature) from the receiver to the
    key. A fake receiver holding the PSK (a stolen receiver, for example)
    could therefore overwrite or delete OTP slots, set access codes or change
    the device configuration without a touch.
    The key runs a command when the last of the ten feature reports of a
    frame (sequence 9) arrives, and that report carries the command byte.
    otp_ctl_filter.h checks it against an allowlist: HMAC-SHA1 and Yubico
    OTP challenge-response, and reading the serial number and capabilities.
    Everything else is blocked, including slot programming, update, swap and
    delete, access codes, NDEF, device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
    [otp_ctl_filter.h, otp_host.c]
2026-10-24 relay: tighten feature report, FIDO endpoint and CCID response handling
    Smaller findings from the same review:
    - Desk unit, OTP feature reports: tag each request with the connection it
    arrived on. A request from a connection that has since closed is not
    sent to the key, and a GET result goes back only to the connection
    that asked (yd_link_send_on), as CCID already does.
    - Desk unit, FIDO: use the HID interface only when both endpoints exist
    and the IN endpoint's max packet size is 64. The IN transfer buffer is
    64 bytes and CTAPHID reports are 64 bytes.
    - Receiver, CCID: pass a response from the desk unit to the computer only
    if it is within dwMaxCCIDMessageLength (3072), is for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
    [ccid_dev.c, hid_dev.c, main.c, otp_host.c]
2026-10-24 docs: bond handling, blocked OTP commands and what a fake receiver can do
    - SECURITY.md (en/ja): which bonds each unit deletes and keeps, why the
    receiver keeps its registered desk unit's bond, and how the desk unit
    restores a bond replaced by re-pairing inside its 120 s window unless
    the new peer authenticates. After erasing the desk unit's bonds, erase
    the receiver's too.
    - SECURITY.md (en/ja): a fake receiver can also break the key's
    configuration without a touch (OATH reset, PIV/OpenPGP reset after
    using up the retries, management settings over CCID). OTP commands
    that change the key are blocked by the desk unit.
    - SECURITY.md (en/ja): the keyboard filter allows one Enter p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
2026-10-24 relay: stop saying that slot configuration is relayed
    The desk unit now blocks OTP commands that change the key, so slot
    configuration no longer goes through KeyRelay. Only the wording changes:
    - Logs: the receiver's capability line and both units' feature report
    progress line mention challenge-response only. The receiver logs the
    two capability variants with separate ESP_LOGI calls, each with a
    literal format.
    - Comments in yd_link.h, hid_dev.h and otp_host.c.
    - DEV_NOTES (ja), chapters 11.4 and 12, to match the filter described
    there.
    [hid_dev.c, hid_dev.h, main.c, otp_host.c, yd_link.h]
2026-10-24 docs: a re-pairing interrupted by a power loss is not rolled back
    The desk unit keeps the bond replaced by a re-pairing in RAM only. If it
    loses power before the re-paired peer authenticates, the previous bond
    is gone, and the legitimate receiver needs BOOT for 3 s to pair again.
    Say so in SECURITY.md (en/ja).
